quentin-z80/qsbc-zero/qsbc-zero.kicad_pcb

## KiCad design qsbc-zero.kicad_pcb (2022-08-09)

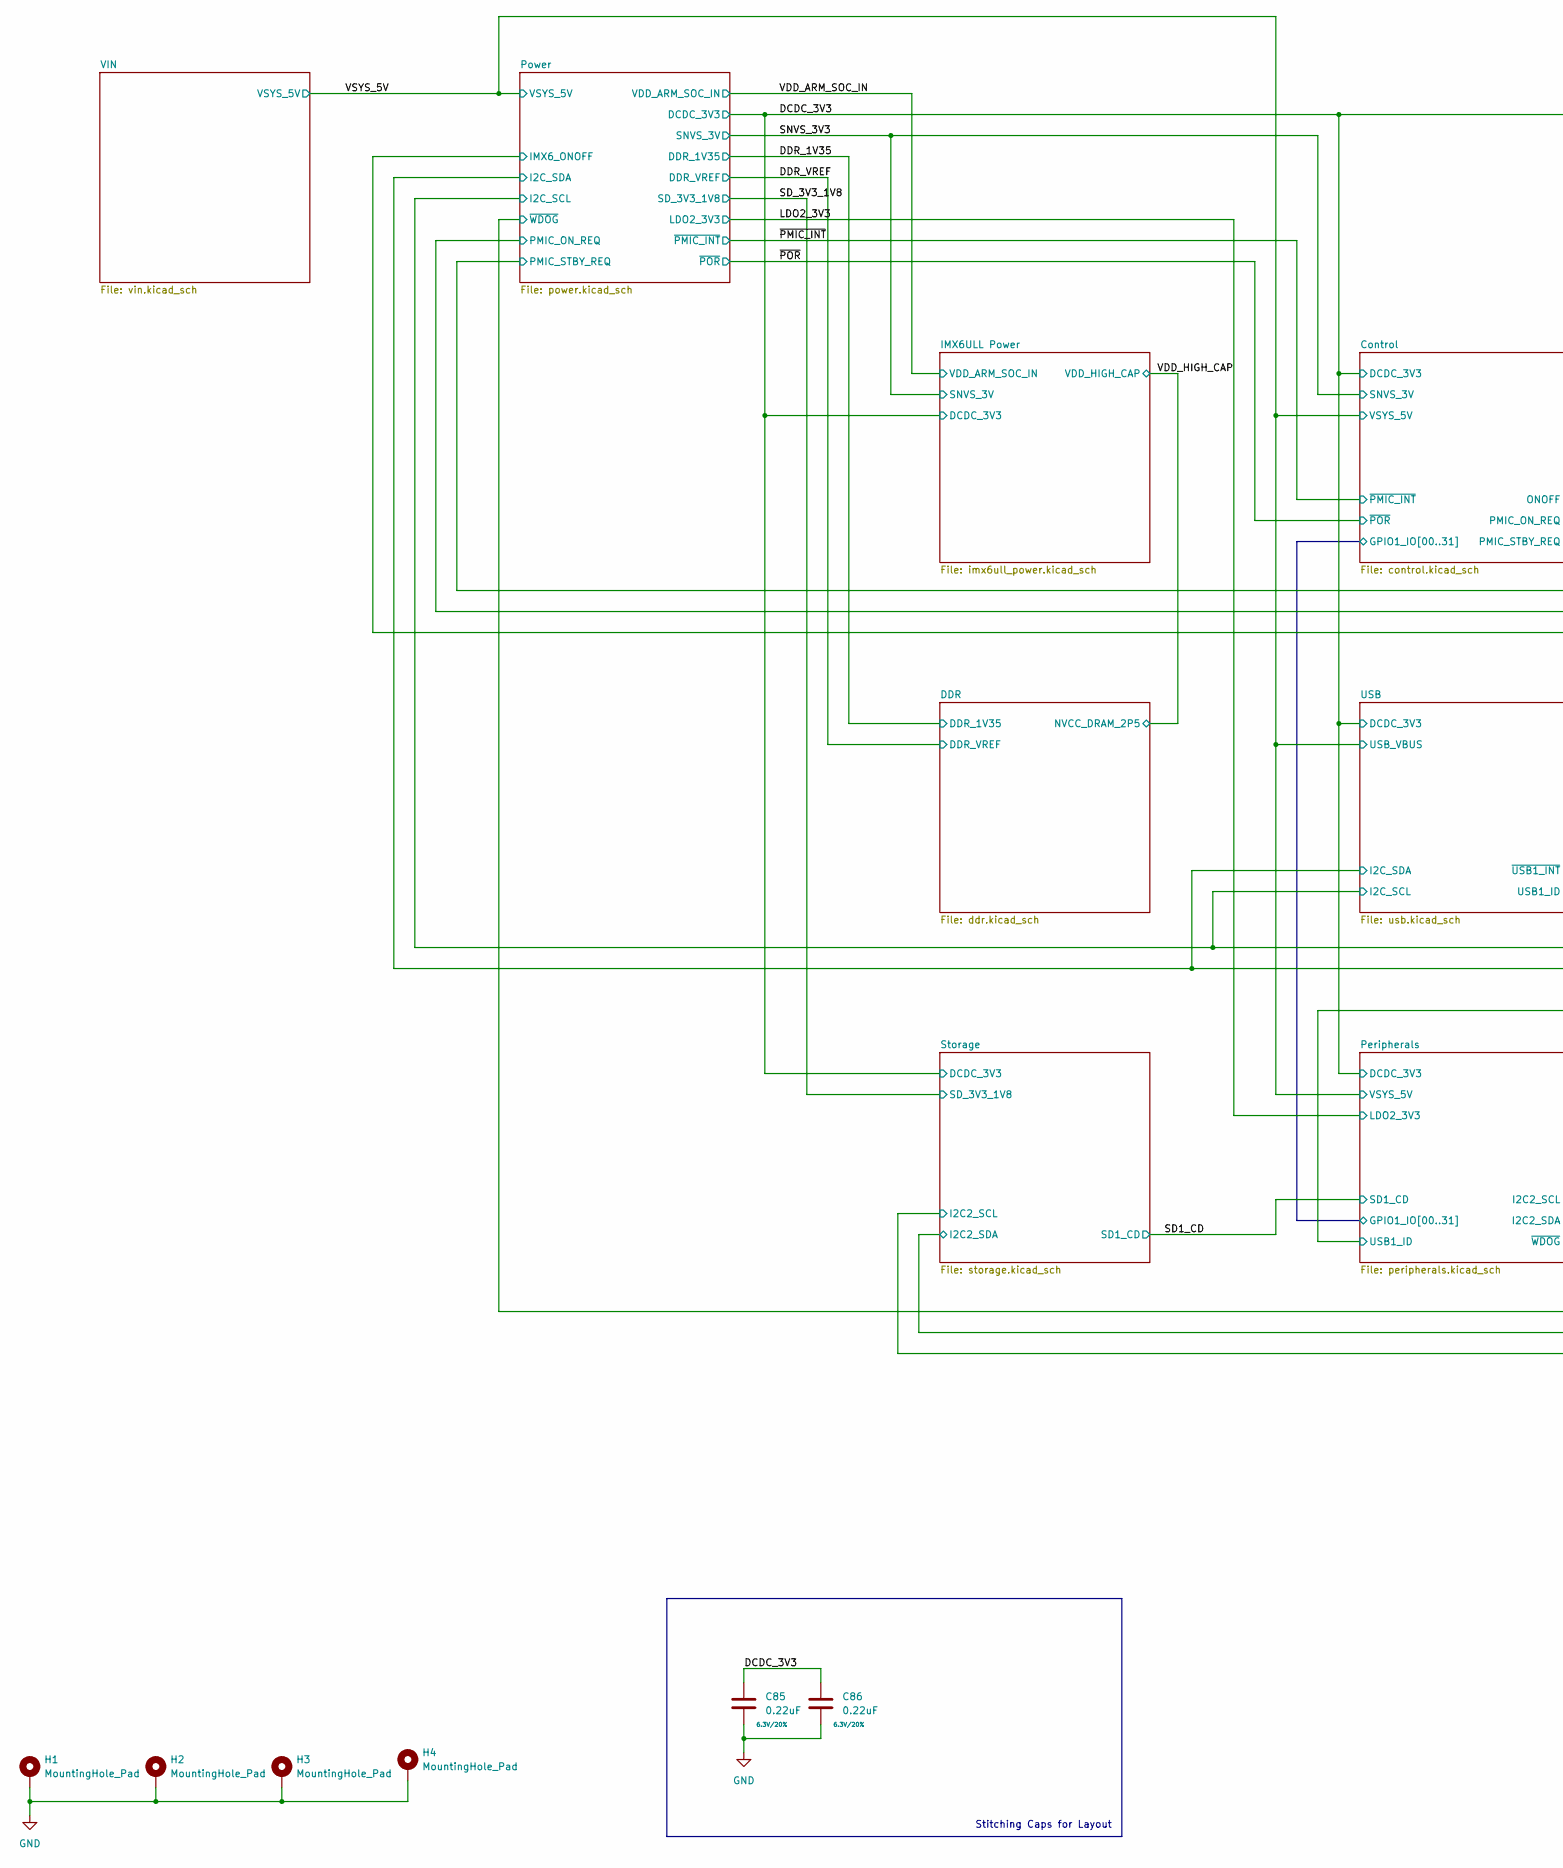
[picture p3: schematic qsbc-zero.kicad_sch, part in row 1, column 1]

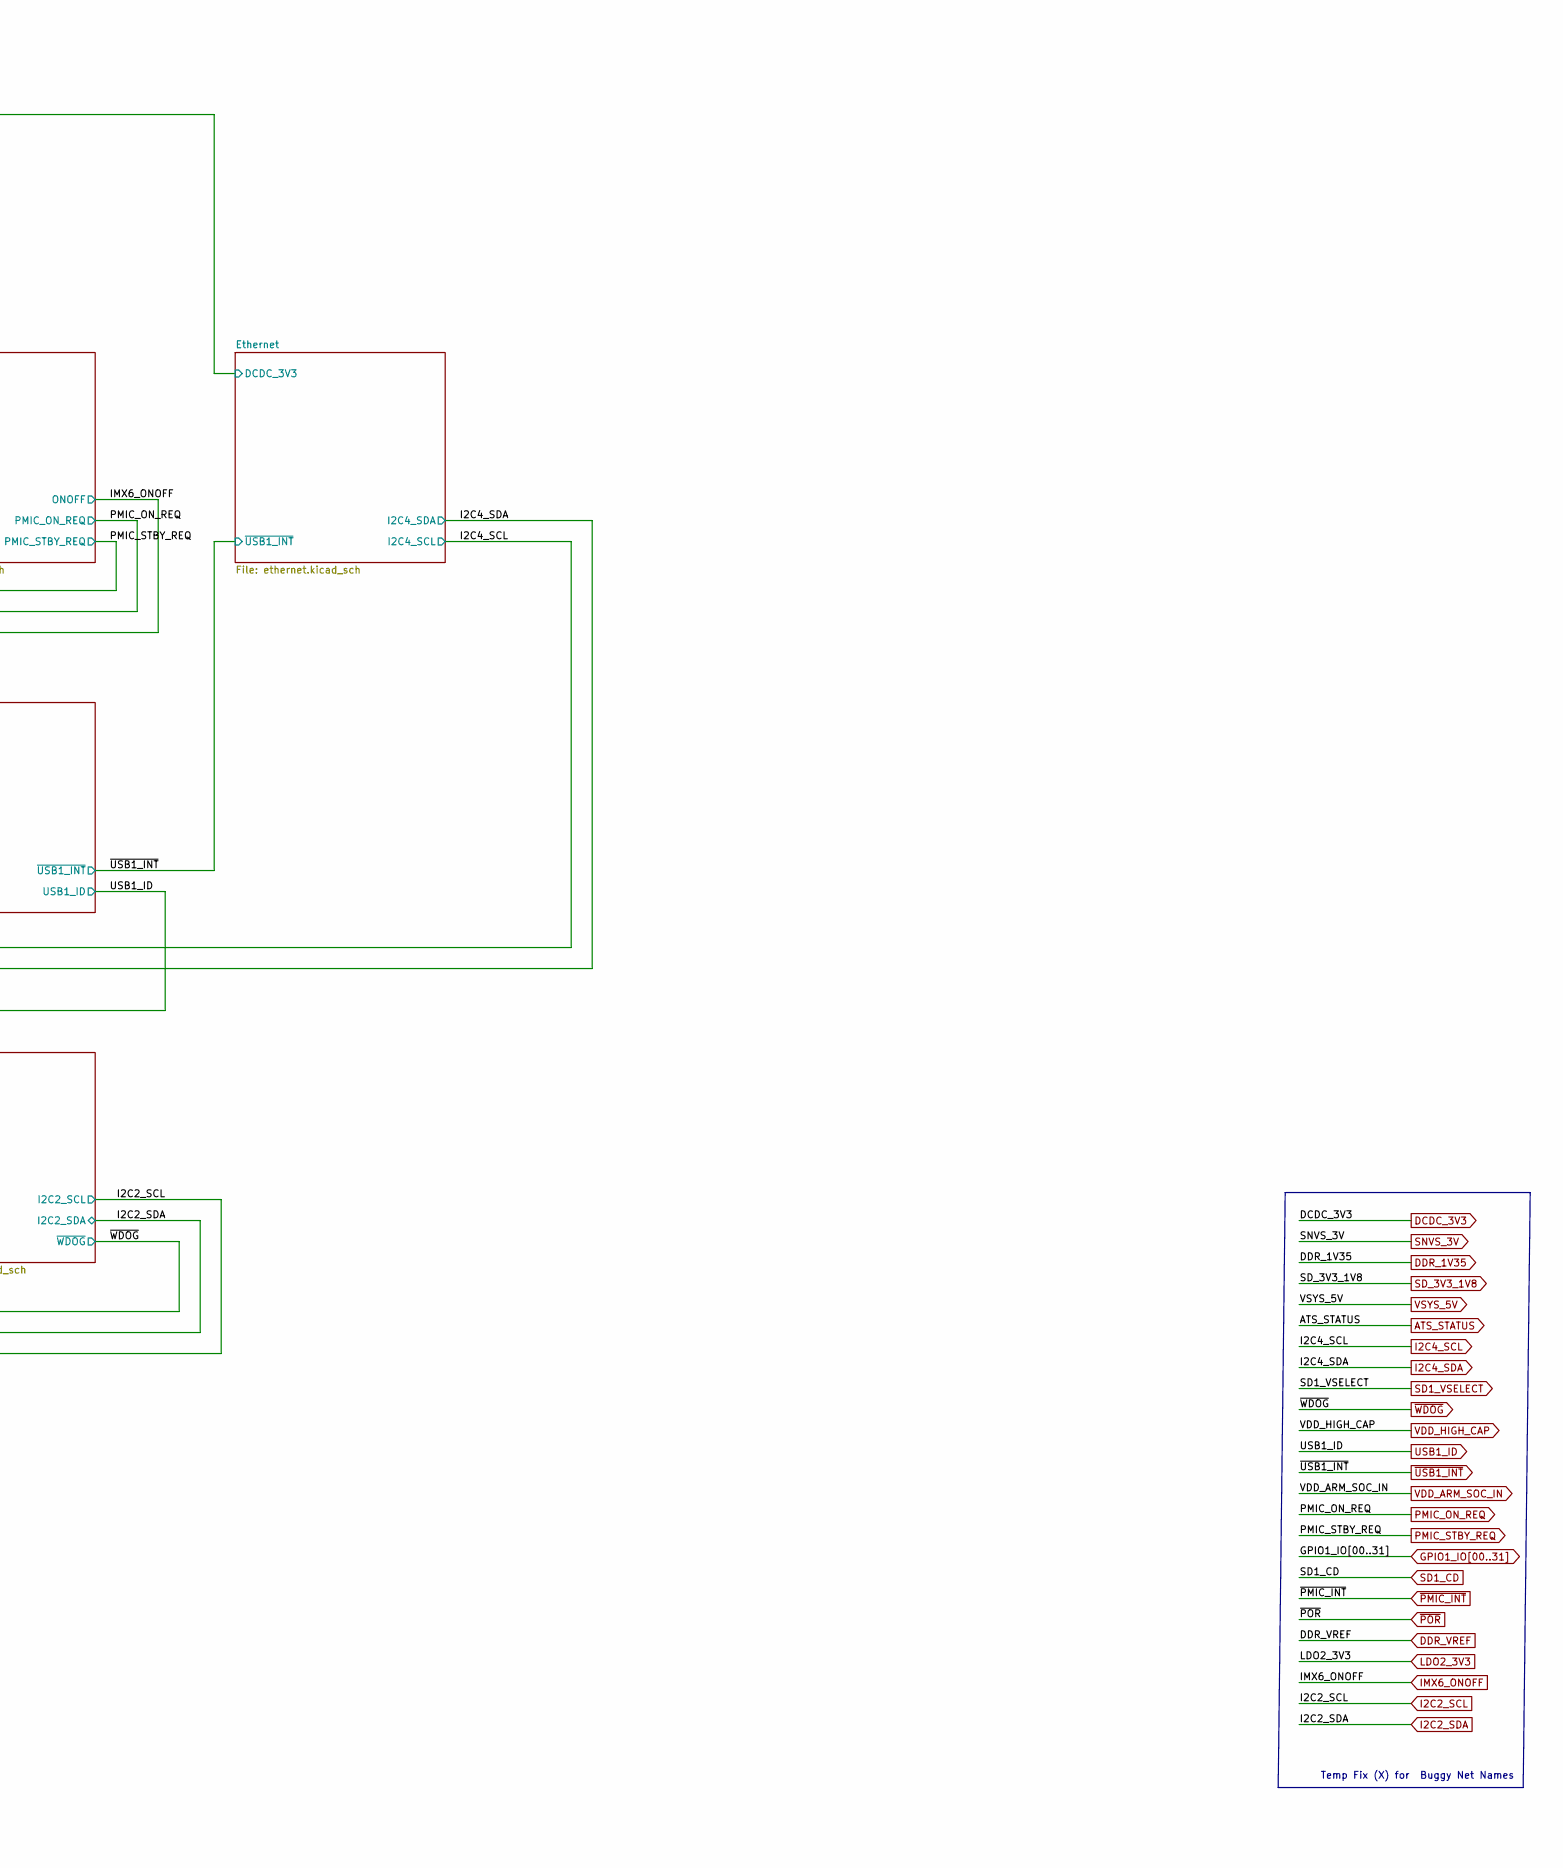
[picture p4: schematic qsbc-zero.kicad_sch, part in row 1, column 2]

Parts:
C85, C86: 0.22uF; C_0201_0603Metric; Rating 6.3V/20%; MPN GRM033C80J224KE90D; DigiKey_PN 490-10392-1-ND
H1, H2, H3, H4: MountingHole_Pad; MountingHole_3.2mm_M3_Pad_Via

Connections:
DCDC_3V3: C85.1, C86.1; also elsewhere on the board
GND: C85.2, C86.2, H1.1, H2.1, H3.1, H4.1; also elsewhere on the board

Notes on the sheet:
Stitching Caps for Layout
Temp Fix (X) for Buggy Net Names

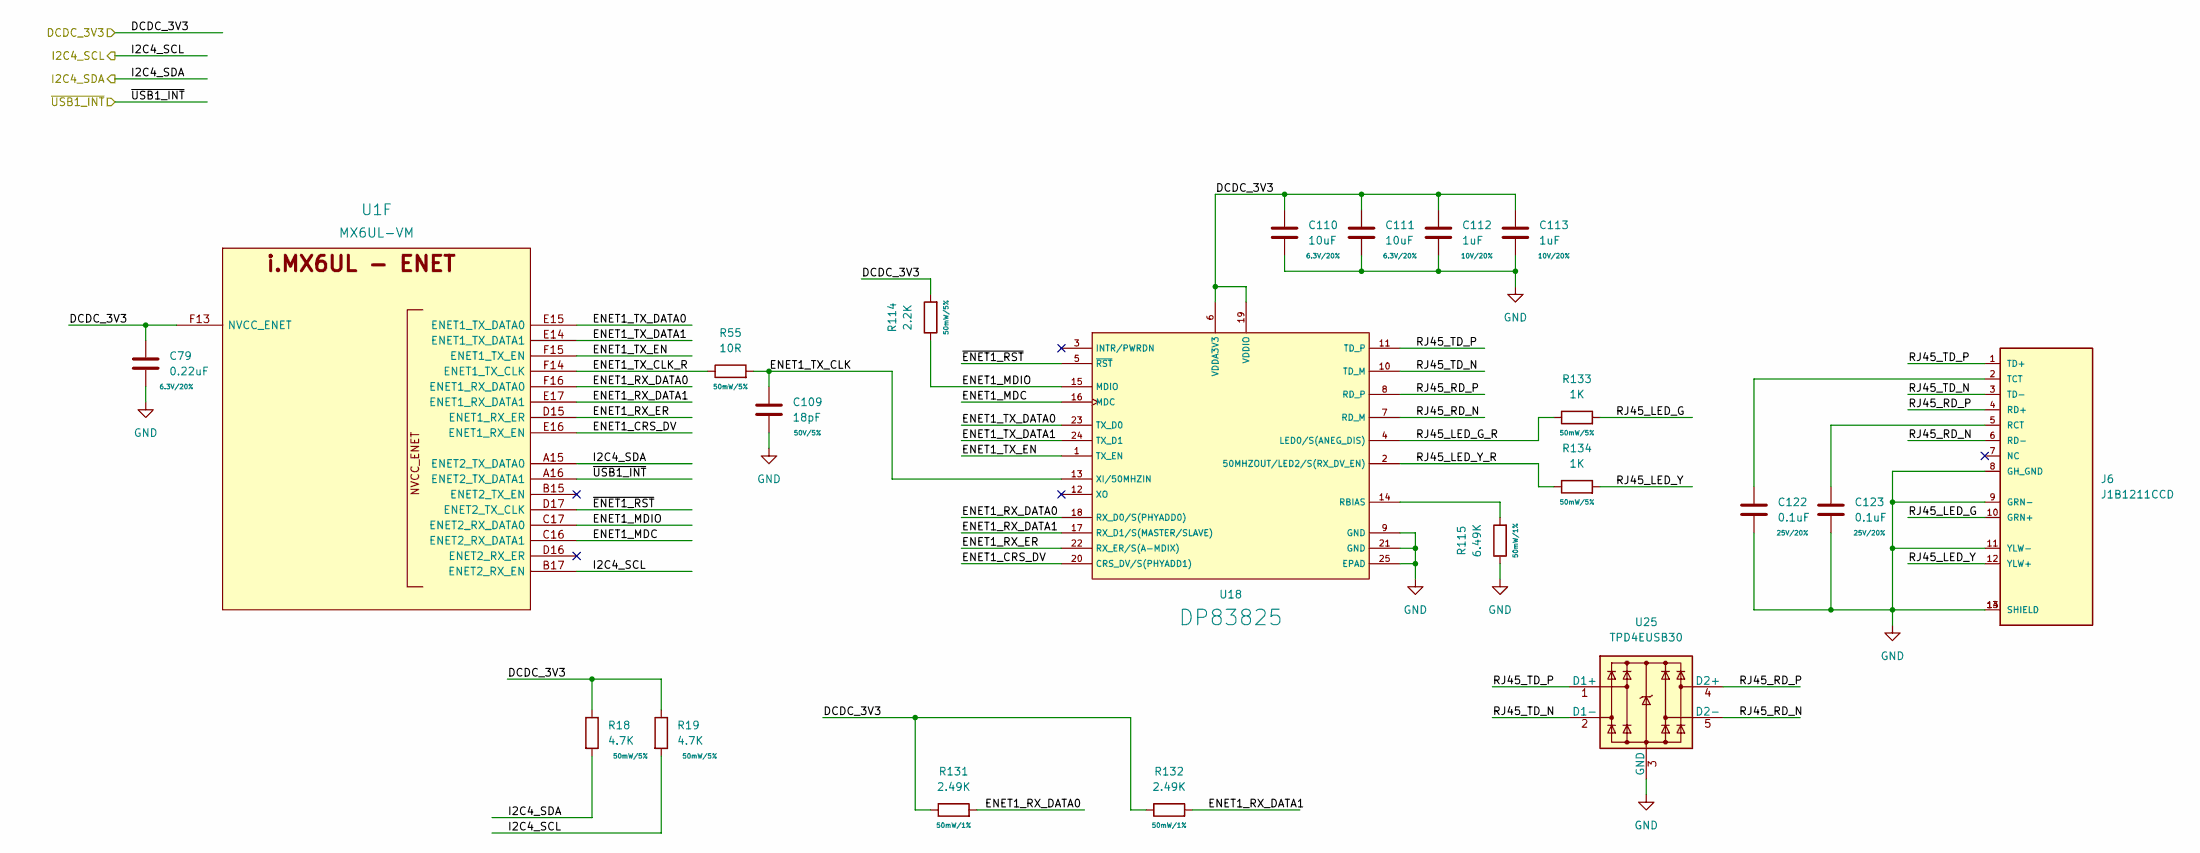
[picture p5: schematic ethernet.kicad_sch]

Parts:
C79: 0.22uF; C_0201_0603Metric; Rating 6.3V/20%; MPN GRM033C80J224KE90D; DigiKey_PN 490-10392-1-ND
C109: 18pF; C_0402_1005Metric; Rating 50V/5%; MPN CC0402JRNPO9BN180; DigiKey_PN 311-1415-1-ND
C110, C111: 10uF; C_0402_1005Metric; Rating 6.3V/20%; MPN GRM155R60J106ME05D; DigiKey_PN 490-GRM155R60J106ME05DCT-ND
C112, C113: 1uF; C_0402_1005Metric; Rating 10V/20%; MPN GCM155C71A105KE38D; DigiKey_PN 490-13409-1-ND
C122, C123: 0.1uF; C_0402_1005Metric; Rating 25V/20%; MPN GRM155R71E104KE14J; DigiKey_PN 490-14603-1-ND
J6: J1B1211CCD; MPN J1B1211CCD; DigiKey_PN 1278-1052-ND
R18, R19: 4.7K; R_0402_1005Metric; Rating 50mW/5%; MPN RC0402JR-074K7L; DigiKey_PN 311-4.7KJRCT-ND
R55: 10R; R_0402_1005Metric; Rating 50mW/5%; MPN RC0402JR-0710RL; DigiKey_PN 311-10JRCT-ND
R114: 2.2K; R_0402_1005Metric; Rating 50mW/5%; MPN RC0402JR-072K2L; DigiKey_PN 311-2.2KJRCT-ND
R115: 6.49K; R_0402_1005Metric; Rating 50mW/1%; MPN RC0402FR-076K49L; DigiKey_PN 311-6.49KLRCT-ND
R131, R132: 2.49K; R_0402_1005Metric; Rating 50mW/1%; MPN RC0402FR-072K49L; DigiKey_PN 311-2.49KLRCT-ND
R133, R134: 1K; R_0402_1005Metric; Rating 50mW/5%; MPN RC0402JR-071KL; DigiKey_PN 311-1.0KJRCT-ND
U1: MX6UL-VM; SOT1534-2; MPN MCIMX6Y2DVM09AB; DigiKey_PN 568-14995-ND
U18: DP83825; XCVR_DP83825IRMQR; MPN DP83825IRMQR; DigiKey_PN 296-DP83825IRMQRCT-ND
U25: TPD4EUSB30; USON-10_2.5x1.0mm_P0.5mm; MPN TPD4EUSB30DQAR; DigiKey_PN 296-28063-1-ND

Connections:
/Ethernet/ENET1_CRS_DV: U1.E16 (ENET1_RX_EN), U18.20 (CRS_DV/S(PHYADD1))
/Ethernet/ENET1_MDC: U1.C16 (ENET2_RX_DATA1), U18.16 (MDC)
/Ethernet/ENET1_MDIO: R114.1, U1.C17 (ENET2_RX_DATA0), U18.15 (MDIO)
/Ethernet/ENET1_RX_DATA0: R131.2, U1.F16 (ENET1_RX_DATA0), U18.18 (RX_D0/S(PHYADD0))
/Ethernet/ENET1_RX_DATA1: R132.2, U1.E17 (ENET1_RX_DATA1), U18.17 (RX_D1/S(MASTER/SLAVE))
/Ethernet/ENET1_RX_ER: U1.D15 (ENET1_RX_ER), U18.22 (RX_ER/S(A-MDIX))
/Ethernet/ENET1_TX_CLK: C109.1, R55.2, U18.13 (XI/50MHZIN)
/Ethernet/ENET1_TX_CLK_R: R55.1, U1.F14 (ENET1_TX_CLK)
/Ethernet/ENET1_TX_DATA0: U1.E15 (ENET1_TX_DATA0), U18.23 (TX_D0)
/Ethernet/ENET1_TX_DATA1: U1.E14 (ENET1_TX_DATA1), U18.24 (TX_D1)
/Ethernet/ENET1_TX_EN: U1.F15 (ENET1_TX_EN), U18.1 (TX_EN)
/Ethernet/RJ45_LED_G: J6.10 (GRN+), R133.2
/Ethernet/RJ45_LED_G_R: R133.1, U18.4 (LED0/S(ANEG_DIS))
/Ethernet/RJ45_LED_Y: J6.12 (YLW+), R134.2
/Ethernet/RJ45_LED_Y_R: R134.1, U18.2 (50MHZOUT/LED2/S(RX_DV_EN))
/Ethernet/RJ45_RD_N: J6.6 (RD-), U18.7 (RD_M), U25.5 (D2-), U25.6
/Ethernet/RJ45_RD_P: J6.4 (RD+), U18.8 (RD_P), U25.4 (D2+), U25.7
/Ethernet/RJ45_TD_N: J6.3 (TD-), U18.10 (TD_M), U25.2 (D1-), U25.9
/Ethernet/RJ45_TD_P: J6.1 (TD+), U18.11 (TD_P), U25.1 (D1+), U25.10
/Ethernet/~ENET1_RST: U1.D17 (ENET2_TX_CLK), U18.5 (~RST)
DCDC_3V3: C79.1, C110.1, C111.1, C112.1, C113.1, R18.1, R19.1, R114.2, R131.1, R132.1, U1.F13 (NVCC_ENET), U18.6 (VDDA3V3), U18.19 (VDDIO); also elsewhere on the board
GND: C79.2, C109.2, C110.2, C111.2, C112.2, C113.2, C122.2, C123.2, J6.8 (GH_GND), J6.9 (GRN-), J6.11 (YLW-), J6.13 (SHIELD), J6.14 (SHIELD), R115.1, U18.9 (GND), U18.21 (GND), U18.25 (EPAD), U18.26 (EPAD), U18.27 (EPAD), U18.28 (EPAD), U18.29 (EPAD), U18.30 (EPAD), U25.3 (GND), U25.8 (GND); also elsewhere on the board
I2C4_SCL: R19.2, U1.B17 (ENET2_RX_EN); also elsewhere on the board
I2C4_SDA: R18.2, U1.A15 (ENET2_TX_DATA0); also elsewhere on the board
unnamed: C122.1, J6.2 (TCT)
unnamed: C123.1, J6.5 (RCT)
unnamed: R115.2, U18.14 (RBIAS)
~USB1_INT: U1.A16 (ENET2_TX_DATA1); also elsewhere on the board

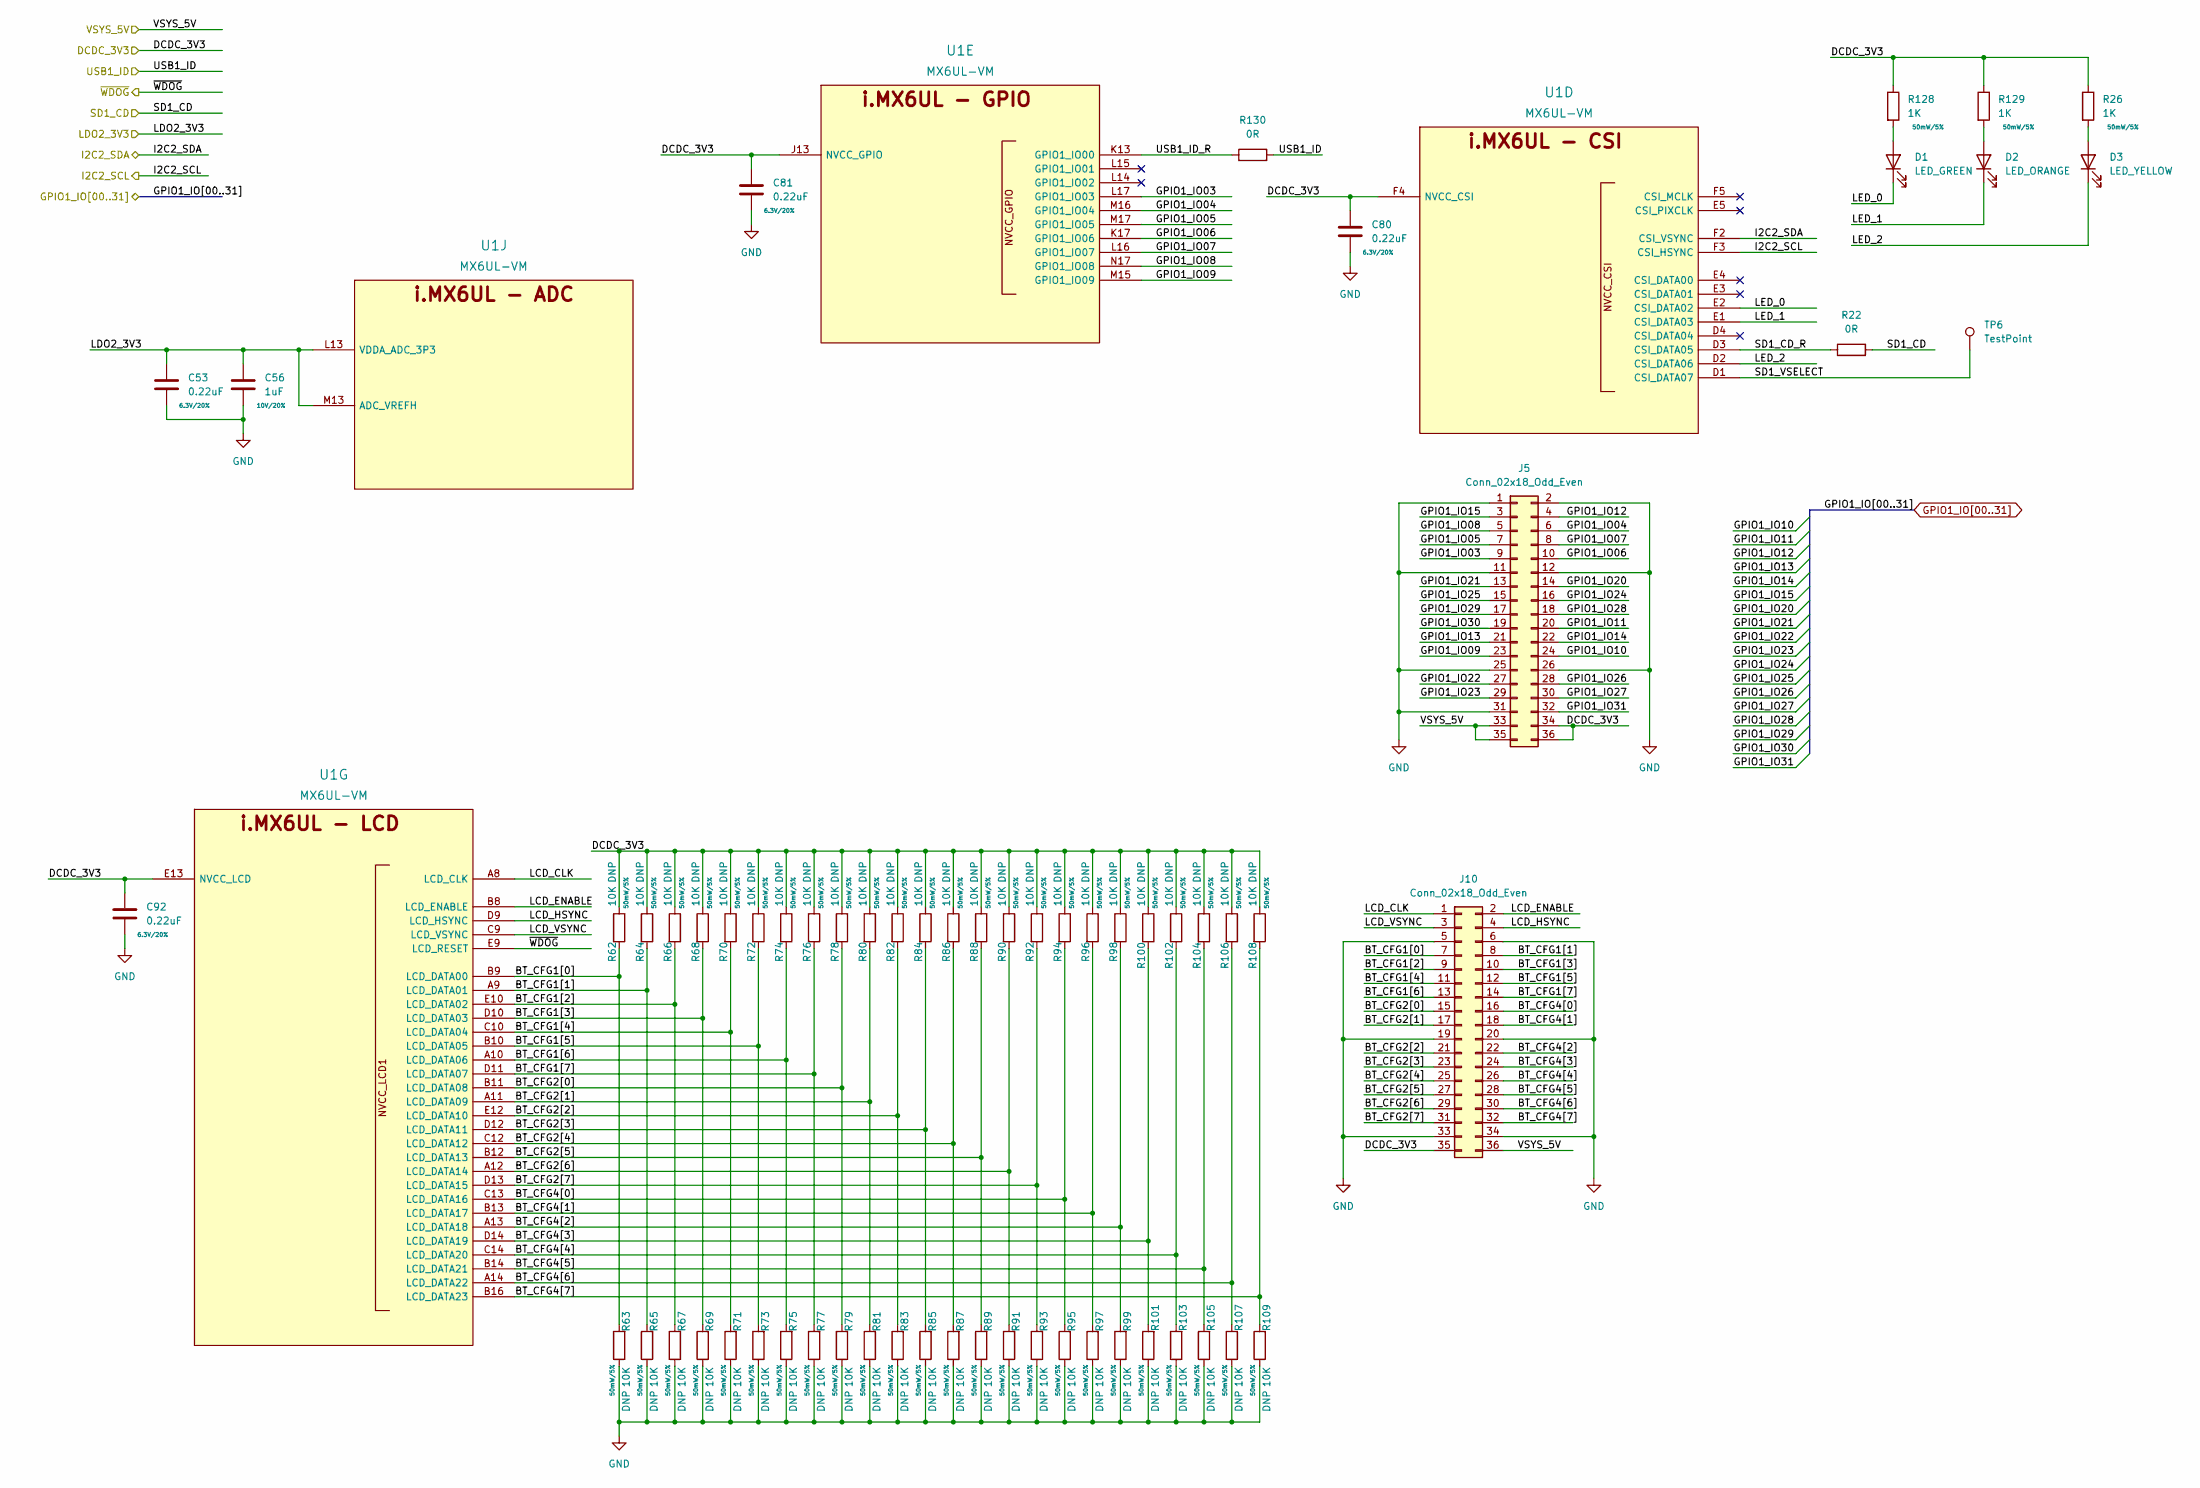
[picture p6: schematic peripherals.kicad_sch]

Parts:
C53, C80, C81, C92: 0.22uF; C_0201_0603Metric; Rating 6.3V/20%; MPN GRM033C80J224KE90D; DigiKey_PN 490-10392-1-ND
C56: 1uF; C_0402_1005Metric; Rating 10V/20%; MPN GCM155C71A105KE38D; DigiKey_PN 490-13409-1-ND
D1: LED_GREEN; LED_0603_1608Metric; MPN SML-D12M8WT86; DigiKey_PN 511-1578-1-ND
D2: LED_ORANGE; LED_0603_1608Metric; MPN SML-E12D8WT86; DigiKey_PN 511-1583-1-ND
D3: LED_YELLOW; LED_0603_1608Metric; MPN SML-E12Y8WT86; DigiKey_PN 511-1588-1-ND
J5, J10: Conn_02x18_Odd_Even; PinHeader_2x18_P2.54mm_Vertical; MPN PRPC018DAAN-RC; DigiKey_PN S2011EC-18-ND
R22, R130: 0R; R_0402_1005Metric; MPN RC0402FR-070RL; DigiKey_PN 311-0.0LRCT-ND
R26, R128, R129: 1K; R_0402_1005Metric; Rating 50mW/5%; MPN RC0402JR-071KL; DigiKey_PN 311-1.0KJRCT-ND
R62, R63, R64, R65, R66, R67, R68, R69, R70, R71, R72, R73, R74, R75, R76, R77, R78, R79, R80, R81, R82, R83, R84, R85, R86, R87, R88, R89, R90, R91, R92, R93, R94, R95, R96, R97, R98, R99, R100, R101, R102, R103, R104, R105, R106, R107, R108, R109: 10K; R_0402_1005Metric; Rating 50mW/5%; MPN RC0402JR-0710KL; DigiKey_PN 311-10KJRCT-ND
TP6: TestPoint; TestPoint_Pad_D1.0mm
U1: MX6UL-VM; SOT1534-2; MPN MCIMX6Y2DVM09AB; DigiKey_PN 568-14995-ND

Connections:
/Peripherals/BT_CFG1[0]: J10.7, R62.2, R63.2, U1.B9 (LCD_DATA00)
/Peripherals/BT_CFG1[1]: J10.8, R64.2, R65.2, U1.A9 (LCD_DATA01)
/Peripherals/BT_CFG1[2]: J10.9, R66.2, R67.2, U1.E10 (LCD_DATA02)
/Peripherals/BT_CFG1[3]: J10.10, R68.2, R69.2, U1.D10 (LCD_DATA03)
/Peripherals/BT_CFG1[4]: J10.11, R70.2, R71.2, U1.C10 (LCD_DATA04)
/Peripherals/BT_CFG1[5]: J10.12, R72.2, R73.2, U1.B10 (LCD_DATA05)
/Peripherals/BT_CFG1[6]: J10.13, R74.2, R75.2, U1.A10 (LCD_DATA06)
/Peripherals/BT_CFG1[7]: J10.14, R76.2, R77.2, U1.D11 (LCD_DATA07)
/Peripherals/BT_CFG2[0]: J10.15, R78.2, R79.2, U1.B11 (LCD_DATA08)
/Peripherals/BT_CFG2[1]: J10.17, R80.2, R81.2, U1.A11 (LCD_DATA09)
/Peripherals/BT_CFG2[2]: J10.21, R82.2, R83.2, U1.E12 (LCD_DATA10)
/Peripherals/BT_CFG2[3]: J10.23, R84.2, R85.2, U1.D12 (LCD_DATA11)
/Peripherals/BT_CFG2[4]: J10.25, R86.2, R87.2, U1.C12 (LCD_DATA12)
/Peripherals/BT_CFG2[5]: J10.27, R88.2, R89.2, U1.B12 (LCD_DATA13)
/Peripherals/BT_CFG2[6]: J10.29, R90.2, R91.2, U1.A12 (LCD_DATA14)
/Peripherals/BT_CFG2[7]: J10.31, R92.2, R93.2, U1.D13 (LCD_DATA15)
/Peripherals/BT_CFG4[0]: J10.16, R94.2, R95.2, U1.C13 (LCD_DATA16)
/Peripherals/BT_CFG4[1]: J10.18, R96.2, R97.2, U1.B13 (LCD_DATA17)
/Peripherals/BT_CFG4[2]: J10.22, R98.2, R99.2, U1.A13 (LCD_DATA18)
/Peripherals/BT_CFG4[3]: J10.24, R100.2, R101.2, U1.D14 (LCD_DATA19)
/Peripherals/BT_CFG4[4]: J10.26, R102.2, R103.2, U1.C14 (LCD_DATA20)
/Peripherals/BT_CFG4[5]: J10.28, R104.2, R105.2, U1.B14 (LCD_DATA21)
/Peripherals/BT_CFG4[6]: J10.30, R106.2, R107.2, U1.A14 (LCD_DATA22)
/Peripherals/BT_CFG4[7]: J10.32, R108.2, R109.2, U1.B16 (LCD_DATA23)
/Peripherals/GPIO1_IO03: J5.9, U1.L17 (GPIO1_IO03)
/Peripherals/GPIO1_IO04: J5.6, U1.M16 (GPIO1_IO04)
/Peripherals/GPIO1_IO05: J5.7, U1.M17 (GPIO1_IO05)
/Peripherals/GPIO1_IO06: J5.10, U1.K17 (GPIO1_IO06)
/Peripherals/GPIO1_IO07: J5.8, U1.L16 (GPIO1_IO07)
/Peripherals/GPIO1_IO08: J5.5, U1.N17 (GPIO1_IO08)
/Peripherals/GPIO1_IO09: J5.23, U1.M15 (GPIO1_IO09)
/Peripherals/LCD_CLK: J10.1, U1.A8 (LCD_CLK)
/Peripherals/LCD_ENABLE: J10.2, U1.B8 (LCD_ENABLE)
/Peripherals/LCD_HSYNC: J10.4, U1.D9 (LCD_HSYNC)
/Peripherals/LCD_VSYNC: J10.3, U1.C9 (LCD_VSYNC)
/Peripherals/LED_0: D1.1 (K), U1.E2 (CSI_DATA02)
/Peripherals/LED_1: D2.1 (K), U1.E1 (CSI_DATA03)
/Peripherals/LED_2: D3.1 (K), U1.D2 (CSI_DATA06)
/Peripherals/SD1_CD_R: R22.1, U1.D3 (CSI_DATA05)
/Peripherals/SD1_VSELECT: TP6.1, U1.D1 (CSI_DATA07)
/Peripherals/USB1_ID_R: R130.1, U1.K13 (GPIO1_IO00)
DCDC_3V3: C80.1, C81.1, C92.1, J5.34, J5.36, J10.35, R26.1, R62.1, R64.1, R66.1, R68.1, R70.1, R72.1, R74.1, R76.1, R78.1, R80.1, R82.1, R84.1, R86.1, R88.1, R90.1, R92.1, R94.1, R96.1, R98.1, R100.1, R102.1, R104.1, R106.1, R108.1, R128.1, R129.1, U1.E13 (NVCC_LCD), U1.F4 (NVCC_CSI), U1.J13 (NVCC_GPIO); also elsewhere on the board
GND: C53.2, C56.2, C80.2, C81.2, C92.2, J5.1, J5.2, J5.11, J5.12, J5.25, J5.26, J5.31, J10.5, J10.6, J10.19, J10.20, J10.33, J10.34, R63.1, R65.1, R67.1, R69.1, R71.1, R73.1, R75.1, R77.1, R79.1, R81.1, R83.1, R85.1, R87.1, R89.1, R91.1, R93.1, R95.1, R97.1, R99.1, R101.1, R103.1, R105.1, R107.1, R109.1; also elsewhere on the board
GPIO1_IO10: J5.24; also elsewhere on the board
GPIO1_IO11: J5.20; also elsewhere on the board
GPIO1_IO12: J5.4; also elsewhere on the board
GPIO1_IO13: J5.21; also elsewhere on the board
GPIO1_IO14: J5.22; also elsewhere on the board
GPIO1_IO15: J5.3; also elsewhere on the board
GPIO1_IO20: J5.14; also elsewhere on the board
GPIO1_IO21: J5.13; also elsewhere on the board
GPIO1_IO22: J5.27; also elsewhere on the board
GPIO1_IO23: J5.29; also elsewhere on the board
GPIO1_IO24: J5.16; also elsewhere on the board
GPIO1_IO25: J5.15; also elsewhere on the board
GPIO1_IO26: J5.28; also elsewhere on the board
GPIO1_IO27: J5.30; also elsewhere on the board
GPIO1_IO28: J5.18; also elsewhere on the board
GPIO1_IO29: J5.17; also elsewhere on the board
GPIO1_IO30: J5.19; also elsewhere on the board
GPIO1_IO31: J5.32; also elsewhere on the board
I2C2_SCL: U1.F3 (CSI_HSYNC); also elsewhere on the board
I2C2_SDA: U1.F2 (CSI_VSYNC); also elsewhere on the board
LDO2_3V3: C53.1, C56.1, U1.L13 (VDDA_ADC_3P3), U1.M13 (ADC_VREFH); also elsewhere on the board
unnamed: D1.2 (A), R128.2
unnamed: D2.2 (A), R129.2
unnamed: D3.2 (A), R26.2
SD1_CD: R22.2; also elsewhere on the board
USB1_ID: R130.2; also elsewhere on the board
VSYS_5V: J5.33, J5.35, J10.36; also elsewhere on the board
~WDOG: U1.E9 (LCD_RESET); also elsewhere on the board

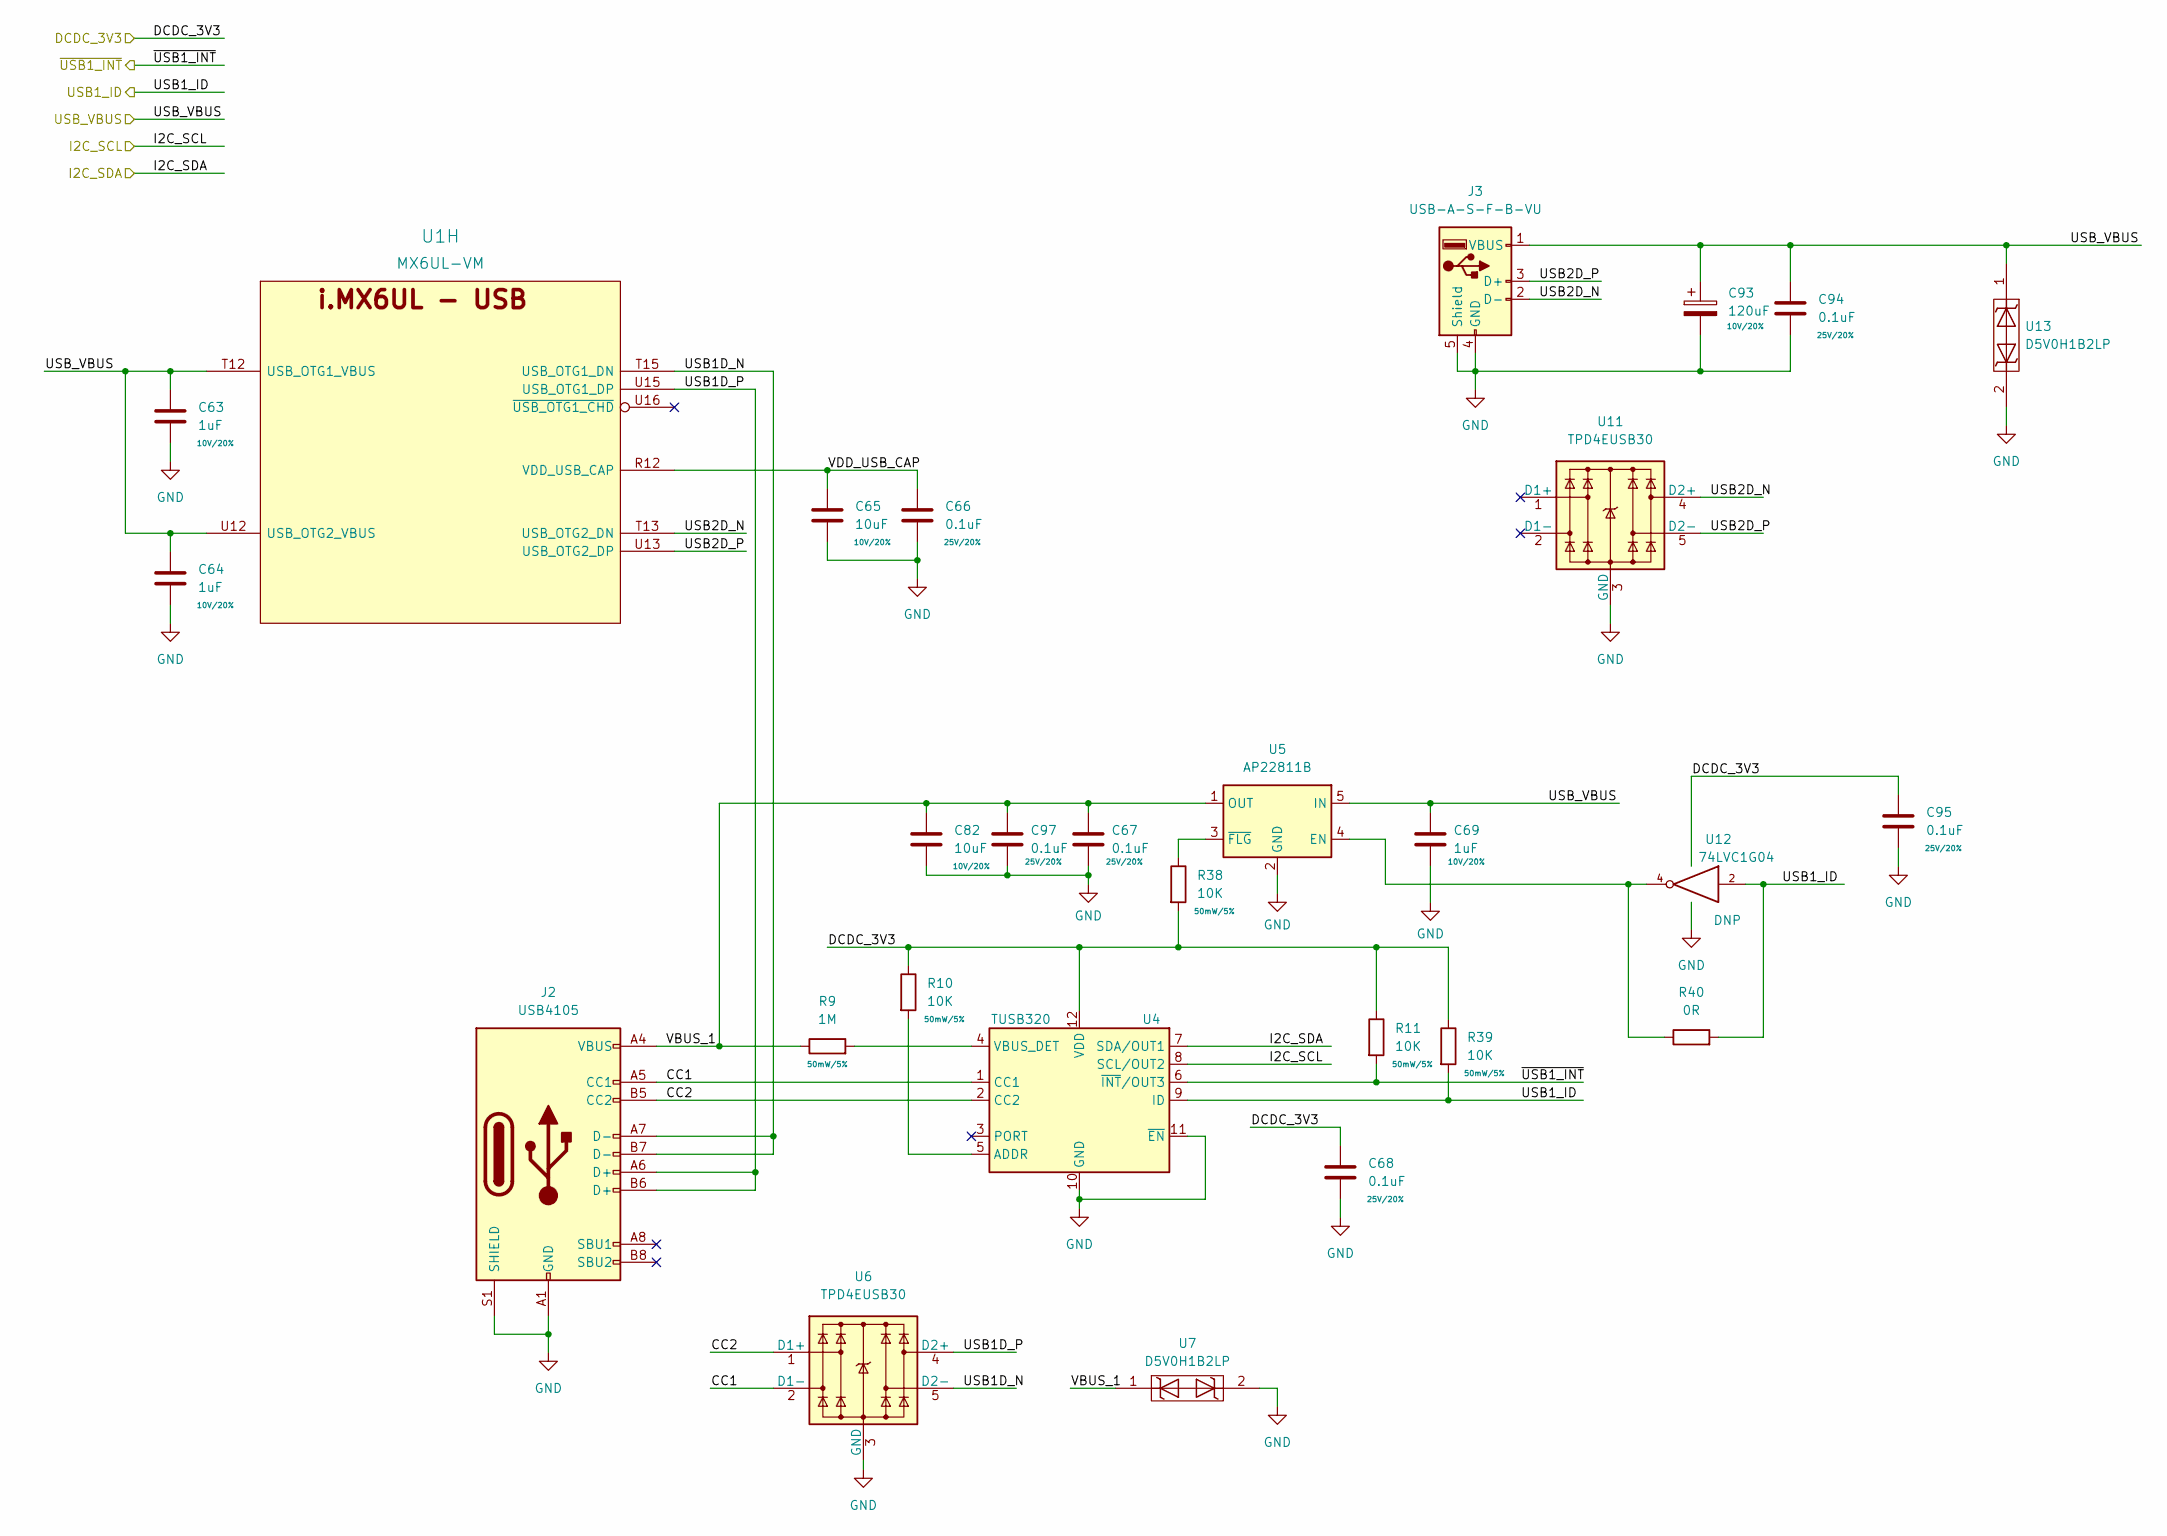
[picture p7: schematic usb.kicad_sch]

Parts:
C63, C64, C69: 1uF; C_0402_1005Metric; Rating 10V/20%; MPN GCM155C71A105KE38D; DigiKey_PN 490-13409-1-ND
C65, C82: 10uF; C_0402_1005Metric; Rating 10V/20%; MPN CL05A106MP5NUNC; DigiKey_PN 1276-1450-1-ND
C66, C67, C68, C94, C95, C97: 0.1uF; C_0402_1005Metric; Rating 25V/20%; MPN GRM155R71E104KE14J; DigiKey_PN 490-14603-1-ND
C93: 120uF; CP_Elec_6.3x4.9; Rating 10V/20%; MPN 875105244013; DigiKey_PN 732-6413-1-ND
J2: USB4105; USB_C_Receptacle_HRO_TYPE-C-31-M-12; MPN USB4105-GF-A; DigiKey_PN 2073-USB4105-GF-ACT-ND
J3: USB-A-S-F-B-VU; SAMTEC_USB-A-S-X-X-VU; MPN USB-A-S-F-B-VU; DigiKey_PN SAM10862-ND
R9: 1M; R_0402_1005Metric; Rating 50mW/5%; MPN RC0402JR-071ML; DigiKey_PN 311-1.0MJRCT-ND
R10, R11, R38, R39: 10K; R_0402_1005Metric; Rating 50mW/5%; MPN RC0402JR-0710KL; DigiKey_PN 311-10KJRCT-ND
R40: 0R; R_0402_1005Metric; MPN RC0402FR-070RL; DigiKey_PN 311-0.0LRCT-ND
U1: MX6UL-VM; SOT1534-2; MPN MCIMX6Y2DVM09AB; DigiKey_PN 568-14995-ND
U4: TUSB320; Texas_X2QFN-12_1.6x1.6mm_P0.4mm; MPN TUSB320LAIRWBR; DigiKey_PN 296-43142-1-ND
U5: AP22811B; SOT-23-5; MPN AP22811BW5-7; DigiKey_PN AP22811BW5-7DICT-ND
U6, U11: TPD4EUSB30; USON-10_2.5x1.0mm_P0.5mm; MPN TPD4EUSB30DQAR; DigiKey_PN 296-28063-1-ND
U7, U13: D5V0H1B2LP; DFN100X60X45-2N; MPN D5V0H1B2LP-7B; DigiKey_PN D5V0H1B2LP-7BDICT-ND
U12: 74LVC1G04; SOT-23-5; MPN SN74LVC1G04DBVR; DigiKey_PN 296-11599-1-ND

Connections:
/USB/CC1: J2.A5 (CC1), U4.1 (CC1), U6.2 (D1-), U6.9
/USB/CC2: J2.B5 (CC2), U4.2 (CC2), U6.1 (D1+), U6.10
/USB/USB1D_N: J2.A7 (D-), J2.B7 (D-), U1.T15 (USB_OTG1_DN), U6.5 (D2-), U6.6
/USB/USB1D_P: J2.A6 (D+), J2.B6 (D+), U1.U15 (USB_OTG1_DP), U6.4 (D2+), U6.7
/USB/USB2D_N: J3.2 (D-), U1.T13 (USB_OTG2_DN), U11.4 (D2+), U11.7
/USB/USB2D_P: J3.3 (D+), U1.U13 (USB_OTG2_DP), U11.5 (D2-), U11.6
/USB/VBUS_1: C67.1, C82.1, C97.1, J2.A4 (VBUS), J2.A9 (VBUS), J2.B4 (VBUS), J2.B9 (VBUS), R9.1, U5.1 (OUT), U7.1
/USB/VDD_USB_CAP: C65.1, C66.1, U1.R12 (VDD_USB_CAP)
DCDC_3V3: C68.1, C95.1, R10.1, R11.1, R38.2, R39.1, U4.12 (VDD), U12.5 (VCC); also elsewhere on the board
GND: C63.2, C64.2, C65.2, C66.2, C67.2, C68.2, C69.2, C82.2, C93.2, C94.2, C95.2, C97.2, J2.A1 (GND), J2.A12 (GND), J2.B1 (GND), J2.B12 (GND), J2.S1 (SHIELD), J3.4 (GND), J3.5 (Shield), U4.10 (GND), U4.11 (~EN), U5.2 (GND), U6.3 (GND), U6.8 (GND), U7.2, U11.3 (GND), U11.8 (GND), U12.3 (GND), U13.2; also elsewhere on the board
I2C4_SCL: U4.8 (SCL/OUT2); also elsewhere on the board
I2C4_SDA: U4.7 (SDA/OUT1); also elsewhere on the board
unnamed: R9.2, U4.4 (VBUS_DET)
unnamed: R10.2, U4.5 (ADDR)
unnamed: R38.1, U5.3 (~FLG)
unnamed: R40.1, U5.4 (EN), U12.4
USB1_ID: R39.2, R40.2, U4.9 (ID), U12.2; also elsewhere on the board
VSYS_5V: C63.1, C64.1, C69.1, C93.1, C94.1, J3.1 (VBUS), U1.T12 (USB_OTG1_VBUS), U1.U12 (USB_OTG2_VBUS), U5.5 (IN), U13.1; also elsewhere on the board
~USB1_INT: R11.2, U4.6 (~INT/OUT3); also elsewhere on the board
