quentin-z80/qsbc-zero/qsbc-zero.kicad_pcb

## KiCad design qsbc-zero.kicad_pcb (continued)

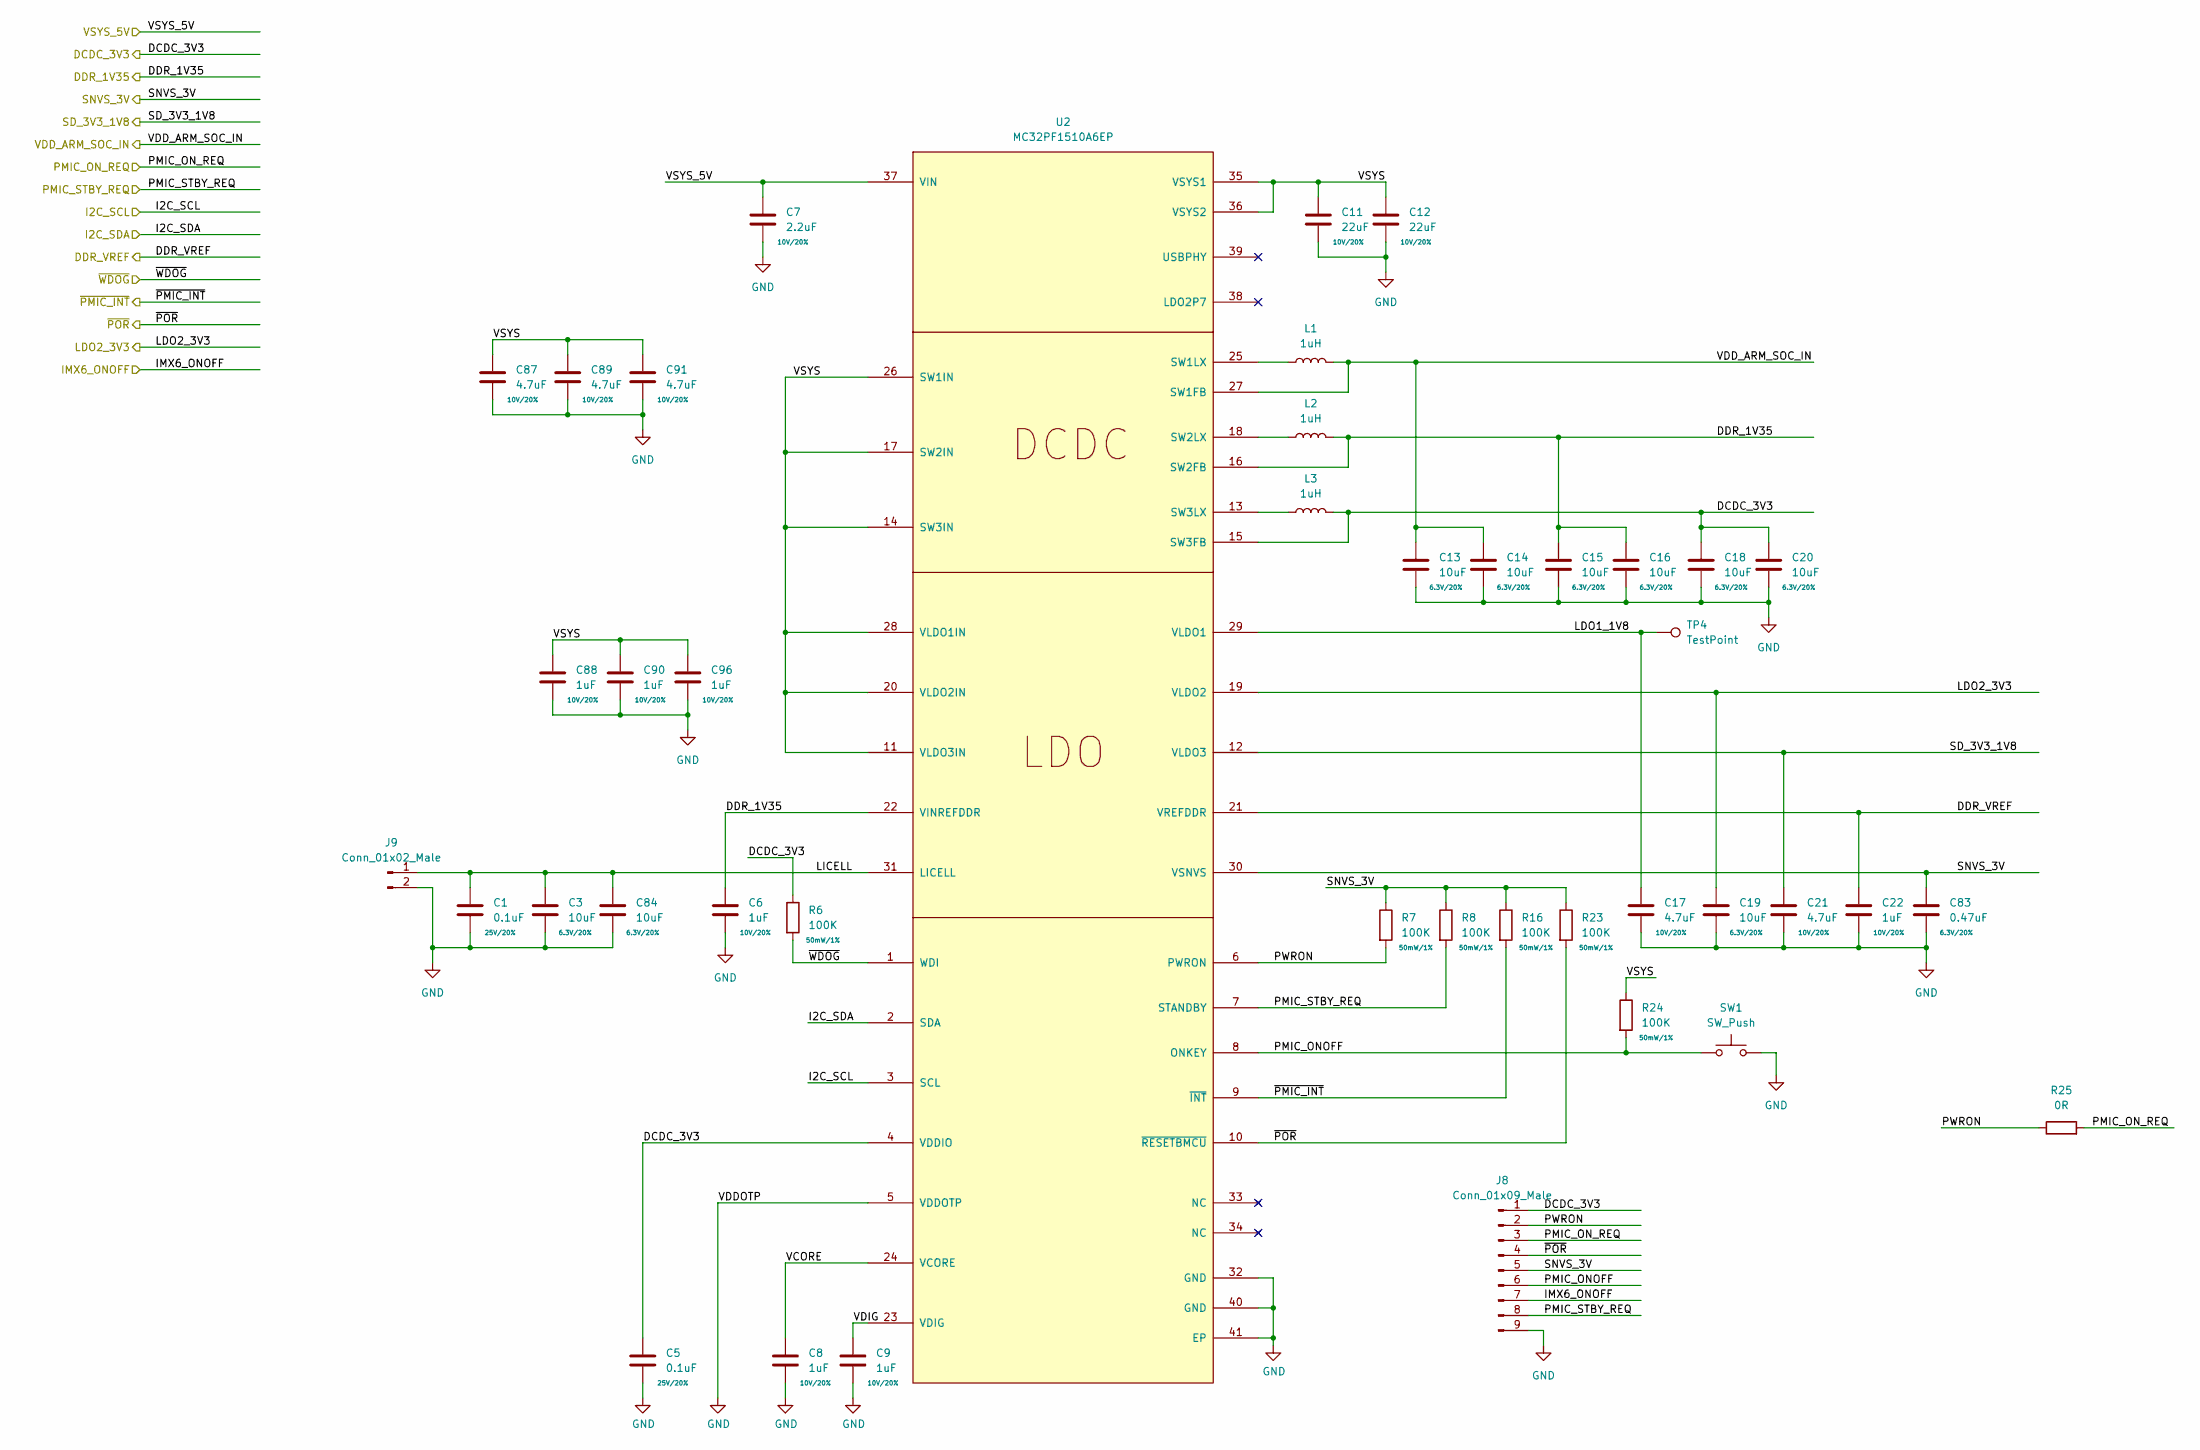
[picture p8: schematic power.kicad_sch]

Parts:
C1, C5: 0.1uF; C_0402_1005Metric; Rating 25V/20%; MPN GRM155R71E104KE14J; DigiKey_PN 490-14603-1-ND
C3, C13, C14, C15, C16, C18, C19, C20, C84: 10uF; C_0402_1005Metric; Rating 6.3V/20%; MPN GRM155R60J106ME05D; DigiKey_PN 490-GRM155R60J106ME05DCT-ND
C6, C8, C9, C22, C88, C90, C96: 1uF; C_0402_1005Metric; Rating 10V/20%; MPN GCM155C71A105KE38D; DigiKey_PN 490-13409-1-ND
C7: 2.2uF; C_0402_1005Metric; Rating 10V/20%; MPN CL05A225MP5NSNC; DigiKey_PN 1276-1467-1-ND
C11, C12: 22uF; C_0603_1608Metric; Rating 10V/20%; MPN CL10A226MP8NUNE; DigiKey_PN 1276-1274-1-ND
C17, C21, C87, C89, C91: 4.7uF; C_0402_1005Metric; Rating 10V/20%; MPN CL05A475MP5NRNC; DigiKey_PN 1276-1482-1-ND
C83: 0.47uF; C_0402_1005Metric; Rating 6.3V/20%; MPN CL05A474KQ5NNNC; DigiKey_PN 1276-1479-1-ND
J8: Conn_01x09_Male; PinHeader_1x09_P1.27mm_Vertical; MPN GRPB091VWVN-RC; DigiKey_PN S9014E-09-ND
J9: Conn_01x02_Male; PinHeader_1x02_P2.54mm_Vertical; MPN PRPC002SAAN-RC; DigiKey_PN S1011EC-02-ND
L1, L2, L3: 1uH; L_0603_1608Metric; MPN DFE18SBN1R0ME0L; DigiKey_PN 490-DFE18SBN1R0ME0LCT-ND
R6, R7, R8, R16, R23, R24: 100K; R_0402_1005Metric; Rating 50mW/1%; MPN CR0402-FX-1003GLF; DigiKey_PN CR0402-FX-1003GLFCT-ND
R25: 0R; R_0402_1005Metric; MPN RC0402FR-070RL; DigiKey_PN 311-0.0LRCT-ND
SW1: SW_Push; SW_Tactile_SPST_Angled_PTS645Vx58-2LFS; MPN PTS645VH58-2 LFS; DigiKey_PN CKN9120-ND
TP4: TestPoint; TestPoint_Pad_D1.0mm
U2: MC32PF1510A6EP; QFN-40-1EP_5x5mm_P0.4mm_EP3.8x3.8mm_ThermalVias; MPN MC32PF1510A6EP; DigiKey_PN MC32PF1510A6EP

Connections:
/Power/LDO1_1V8: C17.1, TP4.1, U2.29 (VLDO1)
/Power/LICELL: C1.1, C3.1, C84.1, J9.1, U2.31 (LICELL)
/Power/PMIC_ONOFF: J8.6, R24.2, SW1.2, U2.8 (ONKEY)
/Power/PWRON: J8.2, R7.2, R25.1, U2.6 (PWRON)
/Power/VCORE: C8.1, U2.24 (VCORE)
/Power/VDIG: C9.1, U2.23 (VDIG)
/Power/VSYS: C11.1, C12.1, C87.1, C88.1, C89.1, C90.1, C91.1, C96.1, R24.1, U2.11 (VLDO3IN), U2.14 (SW3IN), U2.17 (SW2IN), U2.20 (VLDO2IN), U2.26 (SW1IN), U2.28 (VLDO1IN), U2.35 (VSYS1), U2.36 (VSYS2)
/SNVS_3V3: C83.1, J8.5, R7.1, R8.1, R16.1, R23.1, U2.30 (VSNVS); also elsewhere on the board
DCDC_3V3: C5.1, C18.1, C20.1, J8.1, L3.2, R6.1, U2.4 (VDDIO), U2.15 (SW3FB); also elsewhere on the board
DDR_1V35: C6.1, C15.1, C16.1, L2.2, U2.16 (SW2FB), U2.22 (VINREFDDR); also elsewhere on the board
DDR_VREF: C22.1, U2.21 (VREFDDR); also elsewhere on the board
GND: C1.2, C3.2, C5.2, C6.2, C7.2, C8.2, C9.2, C11.2, C12.2, C13.2, C14.2, C15.2, C16.2, C17.2, C18.2, C19.2, C20.2, C21.2, C22.2, C83.2, C84.2, C87.2, C88.2, C89.2, C90.2, C91.2, C96.2, J8.9, J9.2, SW1.1, U2.5 (VDDOTP), U2.32 (GND), U2.40 (GND), U2.41 (EP); also elsewhere on the board
I2C4_SCL: U2.3 (SCL); also elsewhere on the board
I2C4_SDA: U2.2 (SDA); also elsewhere on the board
IMX6_ONOFF: J8.7; also elsewhere on the board
LDO2_3V3: C19.1, U2.19 (VLDO2); also elsewhere on the board
unnamed: L1.1, U2.25 (SW1LX)
unnamed: L2.1, U2.18 (SW2LX)
unnamed: L3.1, U2.13 (SW3LX)
PMIC_ON_REQ: J8.3, R25.2; also elsewhere on the board
PMIC_STBY_REQ: J8.8, R8.2, U2.7 (STANDBY); also elsewhere on the board
SD_3V3_1V8: C21.1, U2.12 (VLDO3); also elsewhere on the board
VDD_ARM_SOC_IN: C13.1, C14.1, L1.2, U2.27 (SW1FB); also elsewhere on the board
VSYS_5V: C7.1, U2.37 (VIN); also elsewhere on the board
~PMIC_INT: R16.2, U2.9 (~INT); also elsewhere on the board
~POR: J8.4, R23.2, U2.10 (~RESETBMCU); also elsewhere on the board
~WDOG: R6.2, U2.1 (WDI); also elsewhere on the board

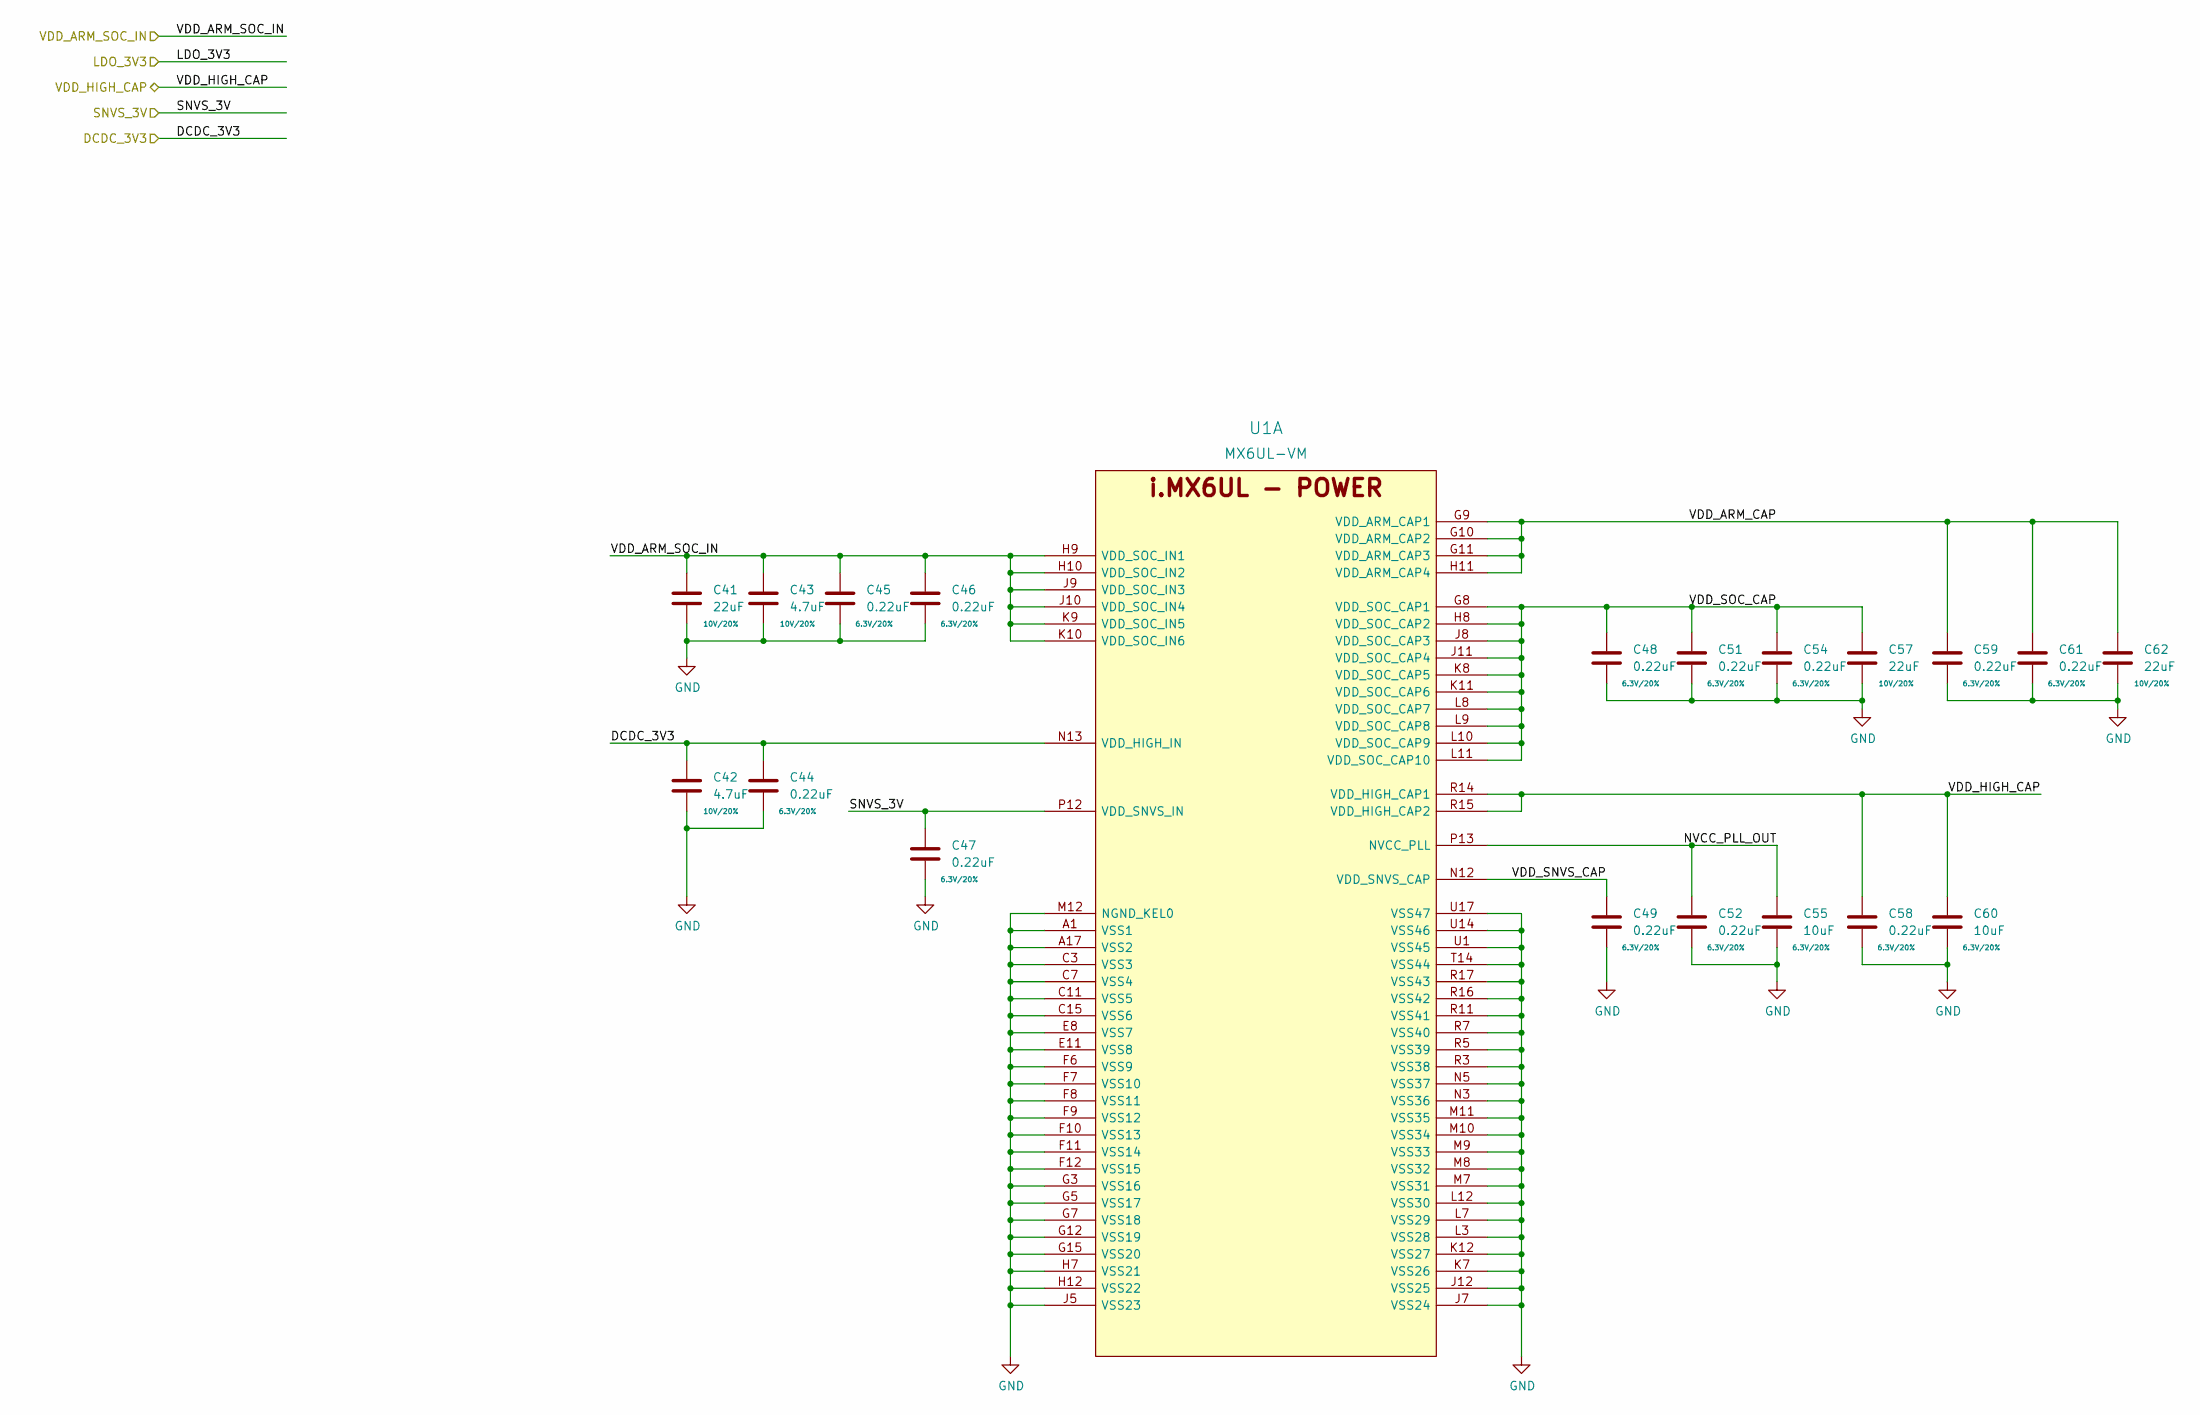
[picture p9: schematic imx6ull_power.kicad_sch]

Parts:
C41, C57, C62: 22uF; C_0603_1608Metric; Rating 10V/20%; MPN CL10A226MP8NUNE; DigiKey_PN 1276-1274-1-ND
C42, C43: 4.7uF; C_0402_1005Metric; Rating 10V/20%; MPN CL05A475MP5NRNC; DigiKey_PN 1276-1482-1-ND
C44, C45, C46, C47, C48, C49, C51, C52, C54, C58, C59, C61: 0.22uF; C_0201_0603Metric; Rating 6.3V/20%; MPN GRM033C80J224KE90D; DigiKey_PN 490-10392-1-ND
C55, C60: 10uF; C_0402_1005Metric; Rating 6.3V/20%; MPN GRM155R60J106ME05D; DigiKey_PN 490-GRM155R60J106ME05DCT-ND
U1: MX6UL-VM; SOT1534-2; MPN MCIMX6Y2DVM09AB; DigiKey_PN 568-14995-ND

Connections:
/IMX6ULL Power/NVCC_PLL_OUT: C52.1, C55.1, U1.P13 (NVCC_PLL)
/IMX6ULL Power/VDD_ARM_CAP: C59.1, C61.1, C62.1, U1.G9 (VDD_ARM_CAP1), U1.G10 (VDD_ARM_CAP2), U1.G11 (VDD_ARM_CAP3), U1.H11 (VDD_ARM_CAP4)
/IMX6ULL Power/VDD_SNVS_CAP: C49.1, U1.N12 (VDD_SNVS_CAP)
/IMX6ULL Power/VDD_SOC_CAP: C48.1, C51.1, C54.1, C57.1, U1.G8 (VDD_SOC_CAP1), U1.H8 (VDD_SOC_CAP2), U1.J8 (VDD_SOC_CAP3), U1.J11 (VDD_SOC_CAP4), U1.K8 (VDD_SOC_CAP5), U1.K11 (VDD_SOC_CAP6), U1.L8 (VDD_SOC_CAP7), U1.L9 (VDD_SOC_CAP8), U1.L10 (VDD_SOC_CAP9), U1.L11 (VDD_SOC_CAP10)
/SNVS_3V3: C47.1, U1.P12 (VDD_SNVS_IN); also elsewhere on the board
DCDC_3V3: C42.1, C44.1, U1.N13 (VDD_HIGH_IN); also elsewhere on the board
GND: C41.2, C42.2, C43.2, C44.2, C45.2, C46.2, C47.2, C48.2, C49.2, C51.2, C52.2, C54.2, C55.2, C57.2, C58.2, C59.2, C60.2, C61.2, C62.2, U1.A1 (VSS1), U1.A17 (VSS2), U1.C3 (VSS3), U1.C7 (VSS4), U1.C11 (VSS5), U1.C15 (VSS6), U1.E8 (VSS7), U1.E11 (VSS8), U1.F6 (VSS9), U1.F7 (VSS10), U1.F8 (VSS11), U1.F9 (VSS12), U1.F10 (VSS13), U1.F11 (VSS14), U1.F12 (VSS15), U1.G3 (VSS16), U1.G5 (VSS17), U1.G7 (VSS18), U1.G12 (VSS19), U1.G15 (VSS20), U1.H7 (VSS21), U1.H12 (VSS22), U1.J5 (VSS23), U1.J7 (VSS24), U1.J12 (VSS25), U1.K7 (VSS26), U1.K12 (VSS27), U1.L3 (VSS28), U1.L7 (VSS29), U1.L12 (VSS30), U1.M7 (VSS31), U1.M8 (VSS32), U1.M9 (VSS33), U1.M10 (VSS34), U1.M11 (VSS35), U1.M12 (NGND_KEL0), U1.N3 (VSS36), U1.N5 (VSS37), U1.R3 (VSS38), U1.R5 (VSS39), U1.R7 (VSS40), U1.R11 (VSS41), U1.R16 (VSS42), U1.R17 (VSS43), U1.T14 (VSS44), U1.U1 (VSS45), U1.U14 (VSS46), U1.U17 (VSS47); also elsewhere on the board
VDD_ARM_SOC_IN: C41.1, C43.1, C45.1, C46.1, U1.H9 (VDD_SOC_IN1), U1.H10 (VDD_SOC_IN2), U1.J9 (VDD_SOC_IN3), U1.J10 (VDD_SOC_IN4), U1.K9 (VDD_SOC_IN5), U1.K10 (VDD_SOC_IN6); also elsewhere on the board
VDD_HIGH_CAP: C58.1, C60.1, U1.R14 (VDD_HIGH_CAP1), U1.R15 (VDD_HIGH_CAP2); also elsewhere on the board

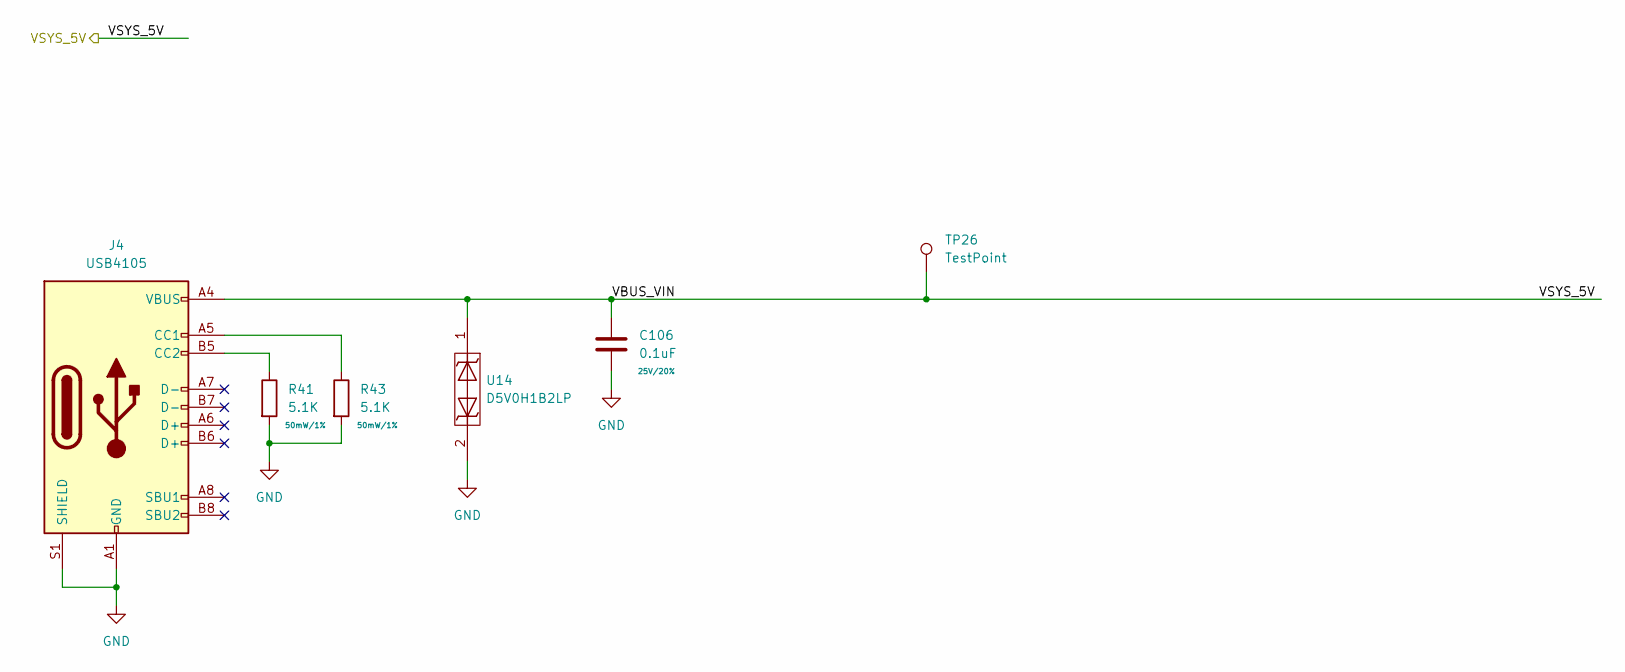
[picture p10: schematic vin.kicad_sch]

Parts:
C106: 0.1uF; C_0402_1005Metric; Rating 25V/20%; MPN GRM155R71E104KE14J; DigiKey_PN 490-14603-1-ND
J4: USB4105; USB_C_Receptacle_HRO_TYPE-C-31-M-12; MPN USB4105-GF-A; DigiKey_PN 2073-USB4105-GF-ACT-ND
R41, R43: 5.1K; R_0402_1005Metric; Rating 50mW/1%; MPN RC0402FR-075K1L; DigiKey_PN 311-5.10KLRCT-ND
TP26: TestPoint; TestPoint_Pad_D1.0mm
U14: D5V0H1B2LP; DFN100X60X45-2N; MPN D5V0H1B2LP-7B; DigiKey_PN D5V0H1B2LP-7BDICT-ND

Connections:
GND: C106.2, J4.A1 (GND), J4.A12 (GND), J4.B1 (GND), J4.B12 (GND), J4.S1 (SHIELD), R41.2, R43.2, U14.2; also elsewhere on the board
unnamed: J4.A5 (CC1), R43.1
unnamed: J4.B5 (CC2), R41.1
VSYS_5V: C106.1, J4.A4 (VBUS), J4.A9 (VBUS), J4.B4 (VBUS), J4.B9 (VBUS), TP26.1, U14.1; also elsewhere on the board

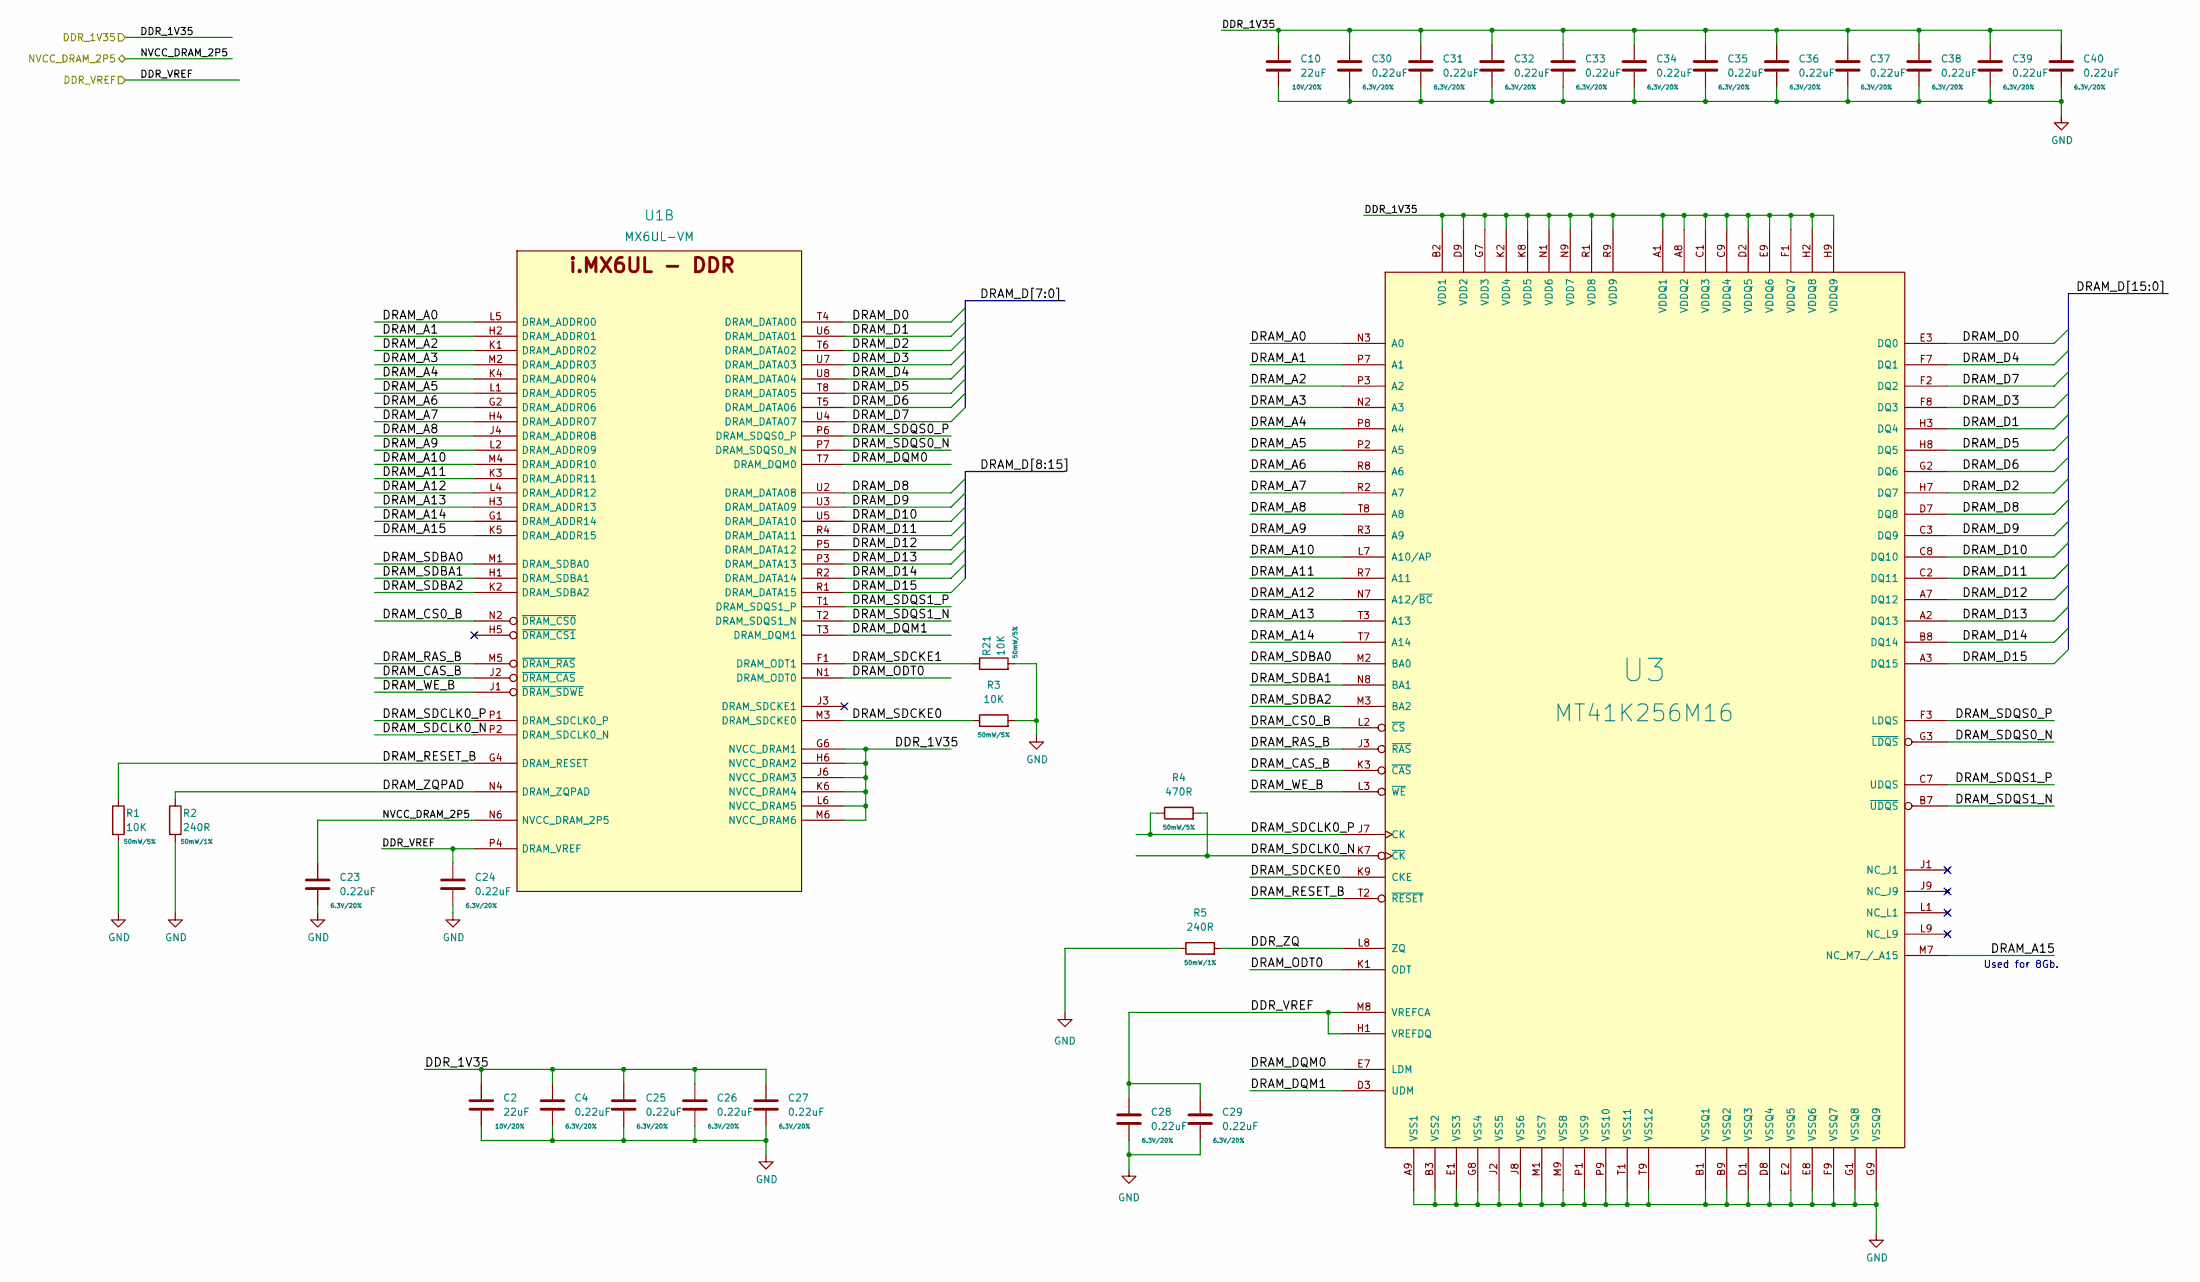
[picture p11: schematic ddr.kicad_sch]

Parts:
C2, C10: 22uF; C_0603_1608Metric; Rating 10V/20%; MPN CL10A226MP8NUNE; DigiKey_PN 1276-1274-1-ND
C4, C23, C24, C25, C26, C27, C28, C29, C30, C31, C32, C33, C34, C35, C36, C37, C38, C39, C40: 0.22uF; C_0201_0603Metric; Rating 6.3V/20%; MPN GRM033C80J224KE90D; DigiKey_PN 490-10392-1-ND
R1, R3, R21: 10K; R_0402_1005Metric; Rating 50mW/5%; MPN RC0402JR-0710KL; DigiKey_PN 311-10KJRCT-ND
R2, R5: 240R; R_0201_0603Metric; Rating 50mW/1%; MPN RC0201FR-07240RL; DigiKey_PN YAG2528CT-ND
R4: 470R; R_0201_0603Metric; Rating 50mW/5%; MPN RC0201JR-07470RL; DigiKey_PN 311-470NCT-ND
U1: MX6UL-VM; SOT1534-2; MPN MCIMX6Y2DVM09AB; DigiKey_PN 568-14995-ND
U3: MT41K256M16; MICRON-FBGA-96; MPN MT41K256M16TW-107:P; DigiKey_PN 557-1792-ND

Connections:
/DDR/DDR_ZQ: R5.2, U3.L8 (ZQ)
/DDR/DRAM_A0: U1.L5 (DRAM_ADDR00), U3.N3 (A0)
/DDR/DRAM_A1: U1.H2 (DRAM_ADDR01), U3.P7 (A1)
/DDR/DRAM_A2: U1.K1 (DRAM_ADDR02), U3.P3 (A2)
/DDR/DRAM_A3: U1.M2 (DRAM_ADDR03), U3.N2 (A3)
/DDR/DRAM_A4: U1.K4 (DRAM_ADDR04), U3.P8 (A4)
/DDR/DRAM_A5: U1.L1 (DRAM_ADDR05), U3.P2 (A5)
/DDR/DRAM_A6: U1.G2 (DRAM_ADDR06), U3.R8 (A6)
/DDR/DRAM_A7: U1.H4 (DRAM_ADDR07), U3.R2 (A7)
/DDR/DRAM_A8: U1.J4 (DRAM_ADDR08), U3.T8 (A8)
/DDR/DRAM_A9: U1.L2 (DRAM_ADDR09), U3.R3 (A9)
/DDR/DRAM_A10: U1.M4 (DRAM_ADDR10), U3.L7 (A10/AP)
/DDR/DRAM_A11: U1.K3 (DRAM_ADDR11), U3.R7 (A11)
/DDR/DRAM_A12: U1.L4 (DRAM_ADDR12), U3.N7 (A12/~BC)
/DDR/DRAM_A13: U1.H3 (DRAM_ADDR13), U3.T3 (A13)
/DDR/DRAM_A14: U1.G1 (DRAM_ADDR14), U3.T7 (A14)
/DDR/DRAM_A15: U1.K5 (DRAM_ADDR15), U3.M7 (NC_M7_/_A15)
/DDR/DRAM_CAS_B: U1.J2 (~DRAM_CAS), U3.K3 (~CAS)
/DDR/DRAM_CS0_B: U1.N2 (~DRAM_CS0), U3.L2 (~CS)
/DDR/DRAM_D0: U1.T4 (DRAM_DATA00), U3.E3 (DQ0)
/DDR/DRAM_D1: U1.U6 (DRAM_DATA01), U3.H3 (DQ4)
/DDR/DRAM_D2: U1.T6 (DRAM_DATA02), U3.H7 (DQ7)
/DDR/DRAM_D3: U1.U7 (DRAM_DATA03), U3.F8 (DQ3)
/DDR/DRAM_D4: U1.U8 (DRAM_DATA04), U3.F7 (DQ1)
/DDR/DRAM_D5: U1.T8 (DRAM_DATA05), U3.H8 (DQ5)
/DDR/DRAM_D6: U1.T5 (DRAM_DATA06), U3.G2 (DQ6)
/DDR/DRAM_D7: U1.U4 (DRAM_DATA07), U3.F2 (DQ2)
/DDR/DRAM_D8: U1.U2 (DRAM_DATA08), U3.D7 (DQ8)
/DDR/DRAM_D9: U1.U3 (DRAM_DATA09), U3.C3 (DQ9)
/DDR/DRAM_D10: U1.U5 (DRAM_DATA10), U3.C8 (DQ10)
/DDR/DRAM_D11: U1.R4 (DRAM_DATA11), U3.C2 (DQ11)
/DDR/DRAM_D12: U1.P5 (DRAM_DATA12), U3.A7 (DQ12)
/DDR/DRAM_D13: U1.P3 (DRAM_DATA13), U3.A2 (DQ13)
/DDR/DRAM_D14: U1.R2 (DRAM_DATA14), U3.B8 (DQ14)
/DDR/DRAM_D15: U1.R1 (DRAM_DATA15), U3.A3 (DQ15)
/DDR/DRAM_DQM0: U1.T7 (DRAM_DQM0), U3.E7 (LDM)
/DDR/DRAM_DQM1: U1.T3 (DRAM_DQM1), U3.D3 (UDM)
/DDR/DRAM_ODT0: U1.N1 (DRAM_ODT0), U3.K1 (ODT)
/DDR/DRAM_RAS_B: U1.M5 (~DRAM_RAS), U3.J3 (~RAS)
/DDR/DRAM_RESET_B: R1.1, U1.G4 (DRAM_RESET), U3.T2 (~RESET)
/DDR/DRAM_SDBA0: U1.M1 (DRAM_SDBA0), U3.M2 (BA0)
/DDR/DRAM_SDBA1: U1.H1 (DRAM_SDBA1), U3.N8 (BA1)
/DDR/DRAM_SDBA2: U1.K2 (DRAM_SDBA2), U3.M3 (BA2)
/DDR/DRAM_SDCKE0: R3.1, U1.M3 (DRAM_SDCKE0), U3.K9 (CKE)
/DDR/DRAM_SDCKE1: R21.1, U1.F1 (DRAM_ODT1)
/DDR/DRAM_SDCLK0_N: R4.2, U1.P2 (DRAM_SDCLK0_N), U3.K7 (~CK)
/DDR/DRAM_SDCLK0_P: R4.1, U1.P1 (DRAM_SDCLK0_P), U3.J7 (CK)
/DDR/DRAM_SDQS0_N: U1.P7 (DRAM_SDQS0_N), U3.G3 (~LDQS)
/DDR/DRAM_SDQS0_P: U1.P6 (DRAM_SDQS0_P), U3.F3 (LDQS)
/DDR/DRAM_SDQS1_N: U1.T2 (DRAM_SDQS1_N), U3.B7 (~UDQS)
/DDR/DRAM_SDQS1_P: U1.T1 (DRAM_SDQS1_P), U3.C7 (UDQS)
/DDR/DRAM_WE_B: U1.J1 (~DRAM_SDWE), U3.L3 (~WE)
/DDR/DRAM_ZQPAD: R2.1, U1.N4 (DRAM_ZQPAD)
DDR_1V35: C2.1, C4.1, C10.1, C25.1, C26.1, C27.1, C30.1, C31.1, C32.1, C33.1, C34.1, C35.1, C36.1, C37.1, C38.1, C39.1, C40.1, U1.G6 (NVCC_DRAM1), U1.H6 (NVCC_DRAM2), U1.J6 (NVCC_DRAM3), U1.K6 (NVCC_DRAM4), U1.L6 (NVCC_DRAM5), U1.M6 (NVCC_DRAM6), U3.A1 (VDDQ1), U3.A8 (VDDQ2), U3.B2 (VDD1), U3.C1 (VDDQ3), U3.C9 (VDDQ4), U3.D2 (VDDQ5), U3.D9 (VDD2), U3.E9 (VDDQ6), U3.F1 (VDDQ7), U3.G7 (VDD3), U3.H2 (VDDQ8), U3.H9 (VDDQ9), U3.K2 (VDD4), U3.K8 (VDD5), U3.N1 (VDD6), U3.N9 (VDD7), U3.R1 (VDD8), U3.R9 (VDD9); also elsewhere on the board
DDR_VREF: C24.1, C28.1, C29.1, U1.P4 (DRAM_VREF), U3.H1 (VREFDQ), U3.M8 (VREFCA); also elsewhere on the board
GND: C2.2, C4.2, C10.2, C23.2, C24.2, C25.2, C26.2, C27.2, C28.2, C29.2, C30.2, C31.2, C32.2, C33.2, C34.2, C35.2, C36.2, C37.2, C38.2, C39.2, C40.2, R1.2, R2.2, R3.2, R5.1, R21.2, U3.A9 (VSS1), U3.B1 (VSSQ1), U3.B3 (VSS2), U3.B9 (VSSQ2), U3.D1 (VSSQ3), U3.D8 (VSSQ4), U3.E1 (VSS3), U3.E2 (VSSQ5), U3.E8 (VSSQ6), U3.F9 (VSSQ7), U3.G1 (VSSQ8), U3.G8 (VSS4), U3.G9 (VSSQ9), U3.J2 (VSS5), U3.J8 (VSS6), U3.M1 (VSS7), U3.M9 (VSS8), U3.P1 (VSS9), U3.P9 (VSS10), U3.T1 (VSS11), U3.T9 (VSS12); also elsewhere on the board
VDD_HIGH_CAP: C23.1, U1.N6 (NVCC_DRAM_2P5); also elsewhere on the board

Notes on the sheet:
Used for 8Gb.

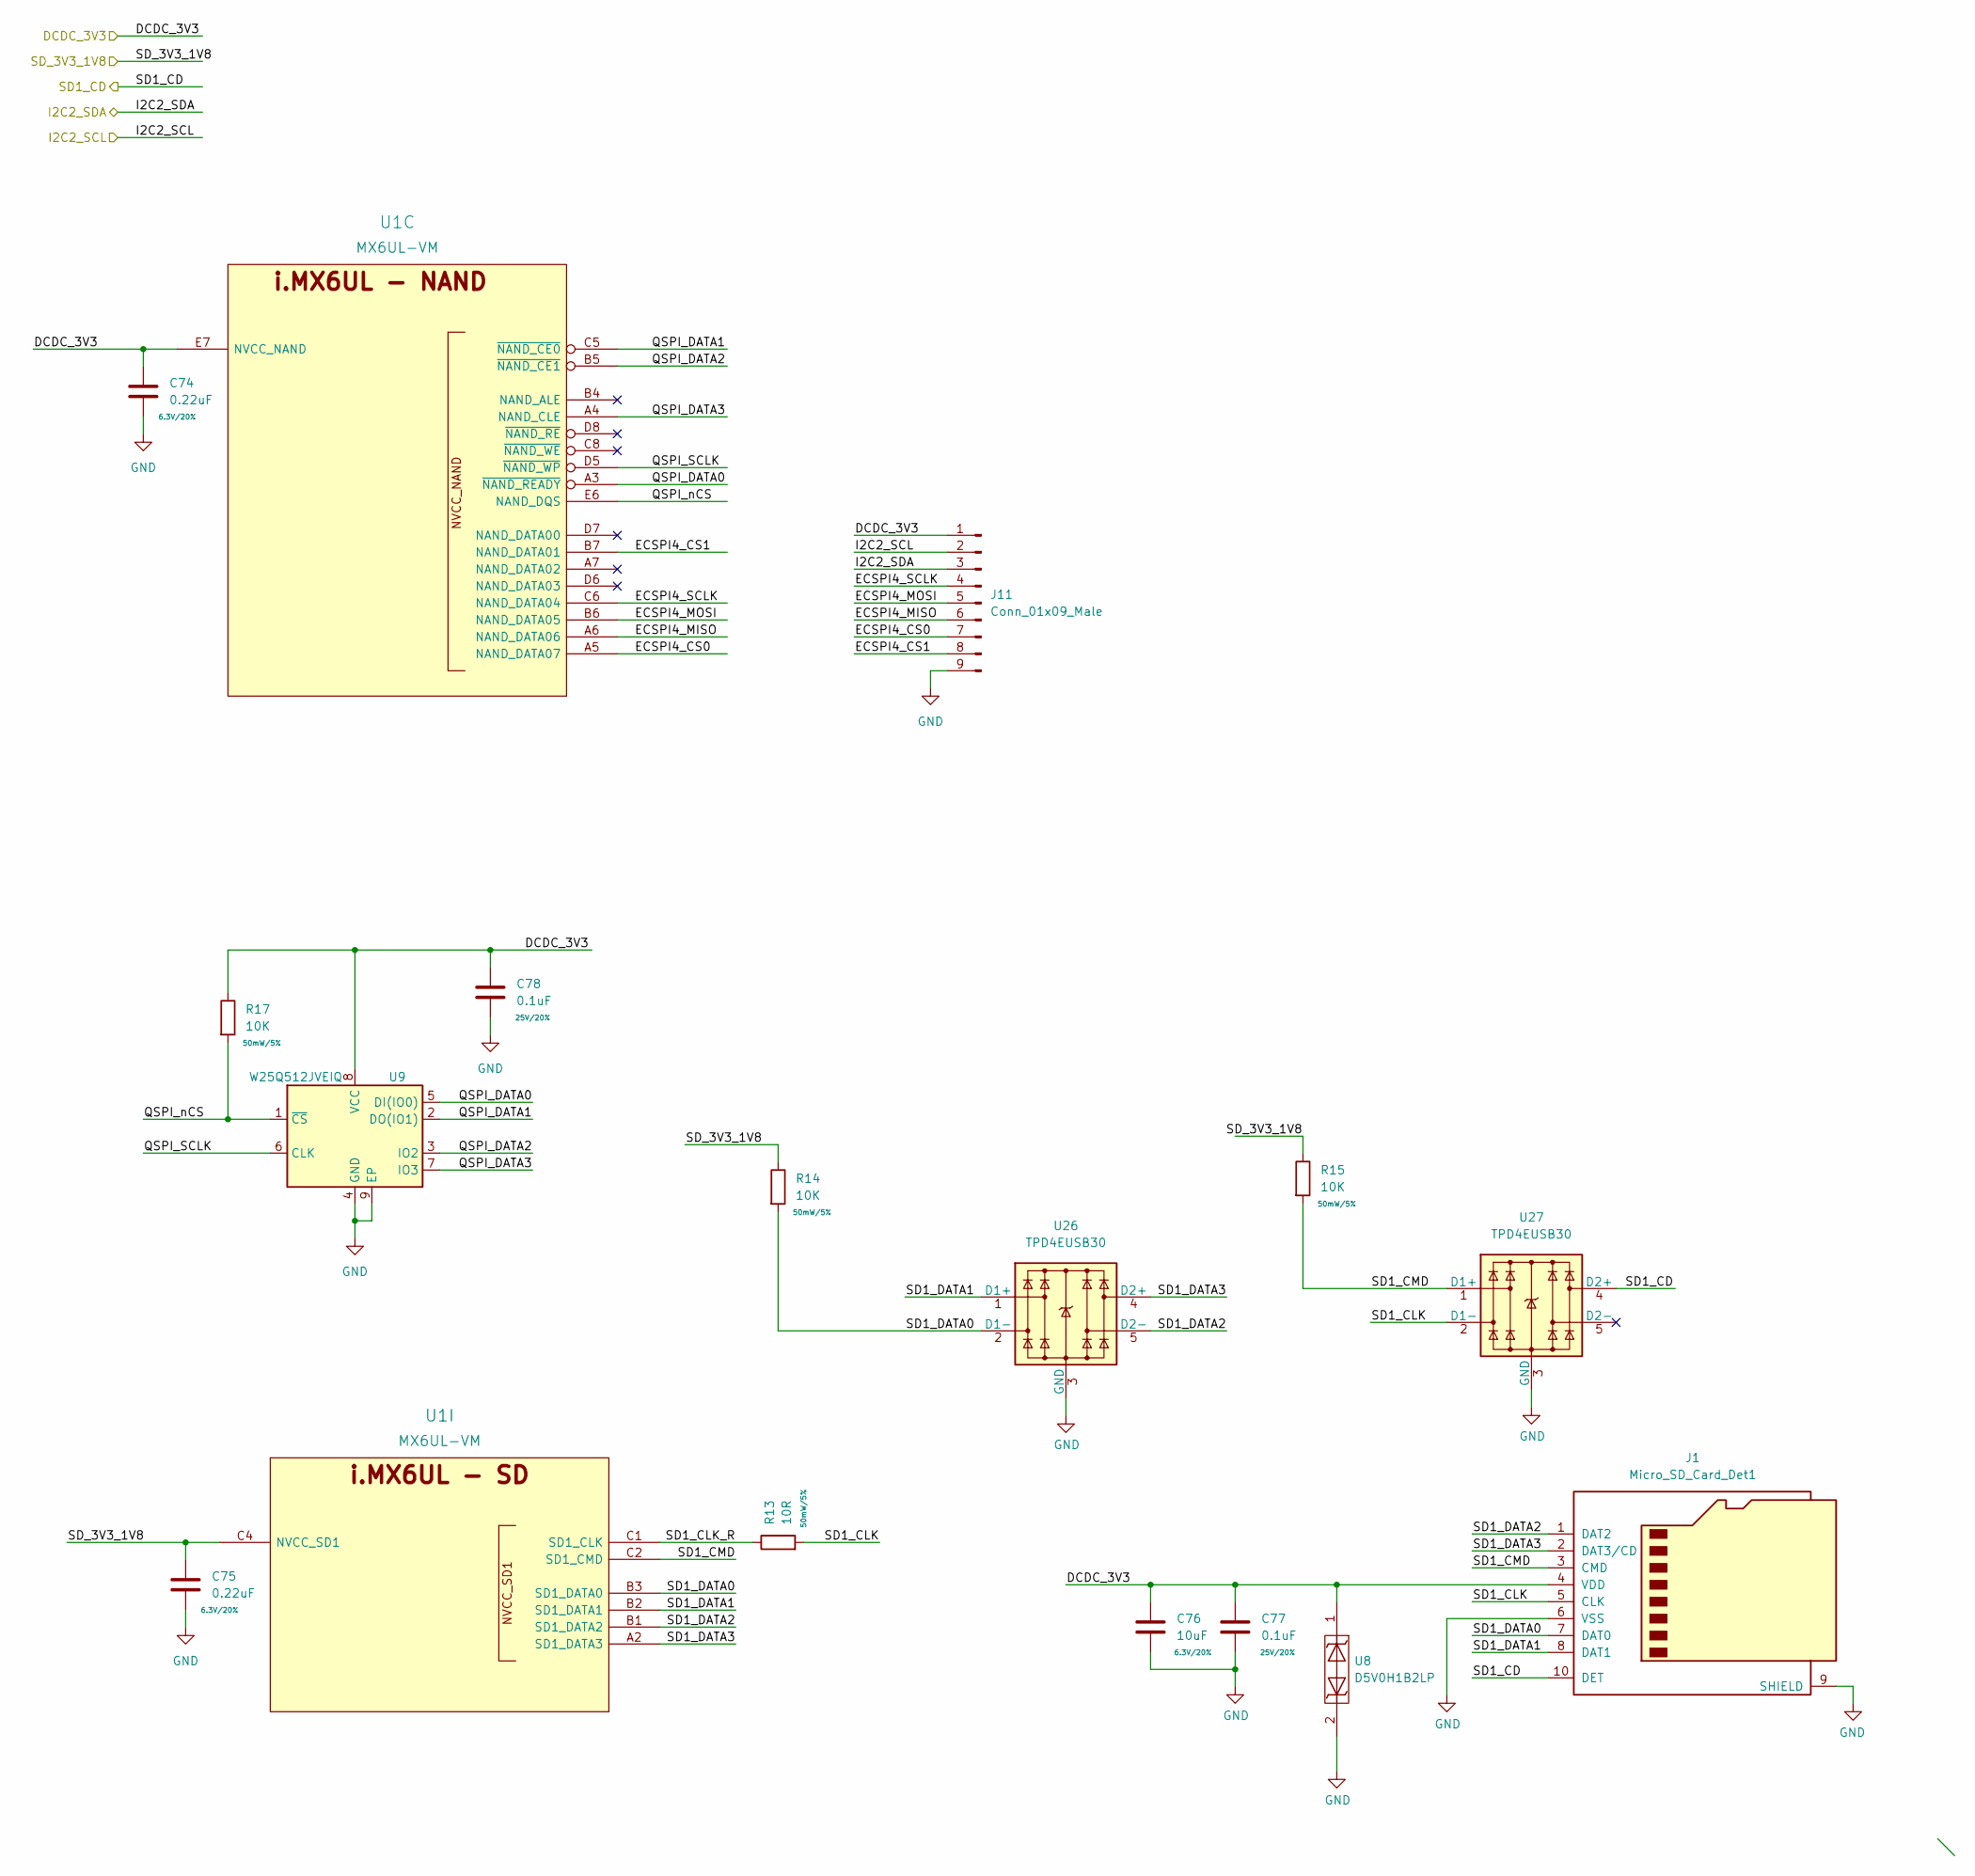
[picture p12: schematic storage.kicad_sch]

Parts:
C74, C75: 0.22uF; C_0201_0603Metric; Rating 6.3V/20%; MPN GRM033C80J224KE90D; DigiKey_PN 490-10392-1-ND
C76: 10uF; C_0402_1005Metric; Rating 6.3V/20%; MPN GRM155R60J106ME05D; DigiKey_PN 490-GRM155R60J106ME05DCT-ND
C77, C78: 0.1uF; C_0402_1005Metric; Rating 25V/20%; MPN GRM155R71E104KE14J; DigiKey_PN 490-14603-1-ND
J1: Micro_SD_Card_Det1; GCT_MEM2051-00-195-00-A_REVC; MPN MEM2051-00-195-00-A; DigiKey_PN 2073-MEM2051-00-195-00-ACT-ND
J11: Conn_01x09_Male; PinHeader_1x09_P1.27mm_Vertical; MPN GRPB091VWVN-RC; DigiKey_PN S9014E-09-ND
R13: 10R; R_0402_1005Metric; Rating 50mW/5%; MPN RC0402JR-0710RL; DigiKey_PN 311-10JRCT-ND
R14, R15, R17: 10K; R_0402_1005Metric; Rating 50mW/5%; MPN RC0402JR-0710KL; DigiKey_PN 311-10KJRCT-ND
U1: MX6UL-VM; SOT1534-2; MPN MCIMX6Y2DVM09AB; DigiKey_PN 568-14995-ND
U8: D5V0H1B2LP; DFN100X60X45-2N; MPN D5V0H1B2LP-7B; DigiKey_PN D5V0H1B2LP-7BDICT-ND
U9: W25Q512JVEIQ; WSON-8-1EP_6x5mm_P1.27mm_EP3.4x4.3mm; MPN W25Q32JVZPIQ; DigiKey_PN W25Q32JVZPIQ-ND
U26, U27: TPD4EUSB30; USON-10_2.5x1.0mm_P0.5mm; MPN TPD4EUSB30DQAR; DigiKey_PN 296-28063-1-ND

Connections:
/Storage/ECSPI4_CS0: J11.7, U1.A5 (NAND_DATA07)
/Storage/ECSPI4_CS1: J11.8, U1.B7 (NAND_DATA01)
/Storage/ECSPI4_MISO: J11.6, U1.A6 (NAND_DATA06)
/Storage/ECSPI4_MOSI: J11.5, U1.B6 (NAND_DATA05)
/Storage/ECSPI4_SCLK: J11.4, U1.C6 (NAND_DATA04)
/Storage/QSPI_DATA0: U1.A3 (~NAND_READY), U9.5 (DI(IO0))
/Storage/QSPI_DATA1: U1.C5 (~NAND_CE0), U9.2 (DO(IO1))
/Storage/QSPI_DATA2: U1.B5 (~NAND_CE1), U9.3 (IO2)
/Storage/QSPI_DATA3: U1.A4 (NAND_CLE), U9.7 (IO3)
/Storage/QSPI_SCLK: U1.D5 (~NAND_WP), U9.6 (CLK)
/Storage/QSPI_nCS: R17.2, U1.E6 (NAND_DQS), U9.1 (~CS)
/Storage/SD1_CLK: J1.5 (CLK), R13.2, U27.2 (D1-), U27.9
/Storage/SD1_CLK_R: R13.1, U1.C1 (SD1_CLK)
/Storage/SD1_CMD: J1.3 (CMD), R15.2, U1.C2 (SD1_CMD), U27.1 (D1+), U27.10
/Storage/SD1_DATA0: J1.7 (DAT0), R14.2, U1.B3 (SD1_DATA0), U26.2 (D1-), U26.9
/Storage/SD1_DATA1: J1.8 (DAT1), U1.B2 (SD1_DATA1), U26.1 (D1+), U26.10
/Storage/SD1_DATA2: J1.1 (DAT2), U1.B1 (SD1_DATA2), U26.5 (D2-), U26.6
/Storage/SD1_DATA3: J1.2 (DAT3/CD), U1.A2 (SD1_DATA3), U26.4 (D2+), U26.7
DCDC_3V3: C74.1, C76.1, C77.1, C78.1, J1.4 (VDD), J11.1, R17.1, U1.E7 (NVCC_NAND), U8.1, U9.8 (VCC); also elsewhere on the board
GND: C74.2, C75.2, C76.2, C77.2, C78.2, J1.6 (VSS), J1.9 (SHIELD), J11.9, U8.2, U9.4 (GND), U9.9 (EP), U26.3 (GND), U26.8 (GND), U27.3 (GND), U27.8 (GND); also elsewhere on the board
I2C2_SCL: J11.2; also elsewhere on the board
I2C2_SDA: J11.3; also elsewhere on the board
SD1_CD: J1.10 (DET), U27.4 (D2+), U27.7; also elsewhere on the board
SD_3V3_1V8: C75.1, R14.1, R15.1, U1.C4 (NVCC_SD1); also elsewhere on the board
