quentin-z80/qsbc-zero/qsbc-zero.kicad_pcb

## KiCad design qsbc-zero.kicad_pcb (continued)

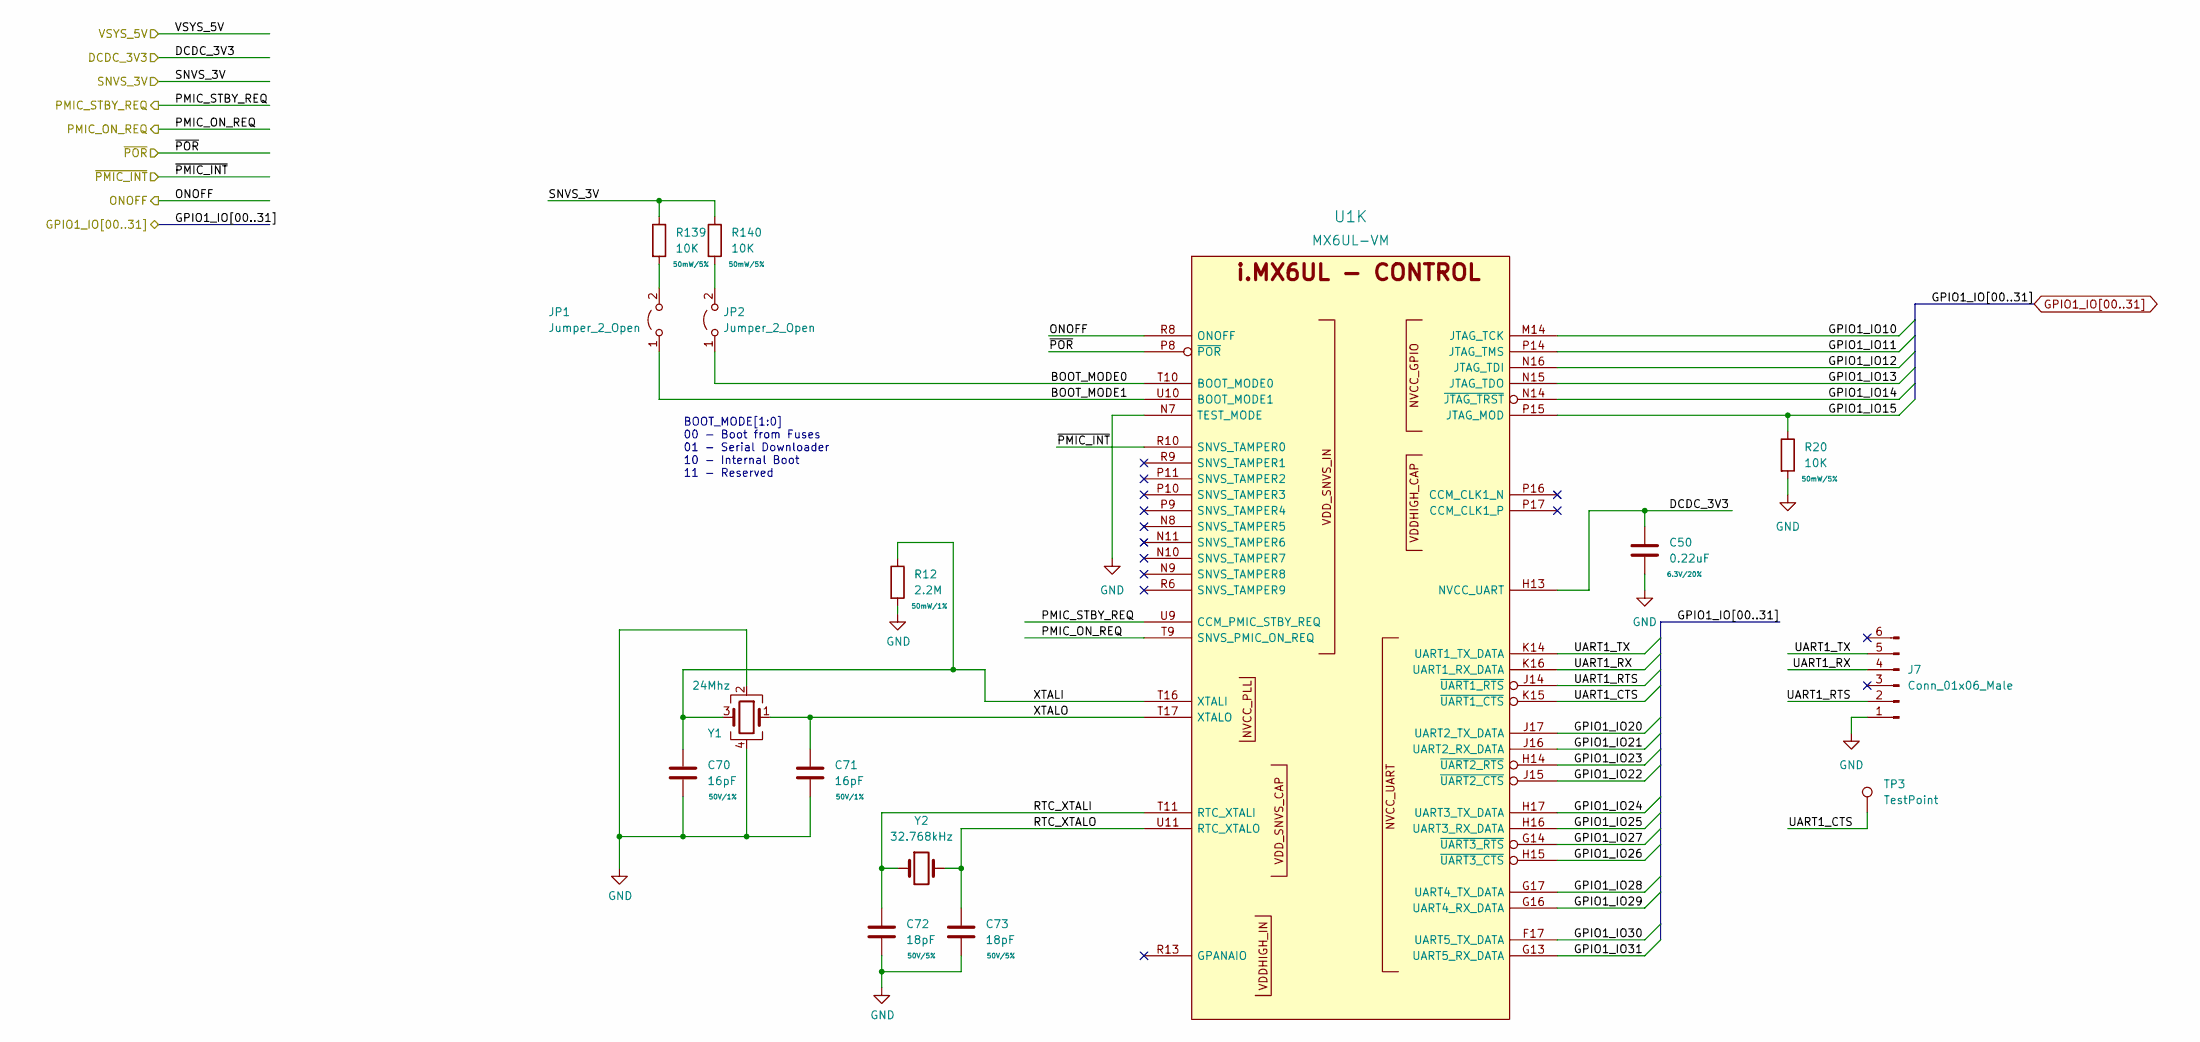
[picture p13: schematic control.kicad_sch]

Parts:
C50: 0.22uF; C_0201_0603Metric; Rating 6.3V/20%; MPN GRM033C80J224KE90D; DigiKey_PN 490-10392-1-ND
C70, C71: 16pF; C_0402_1005Metric; Rating 50V/1%; MPN GCM1555C1H160JA16D; DigiKey_PN 490-GCM1555C1H160JA16DCT-ND
C72, C73: 18pF; C_0402_1005Metric; Rating 50V/5%; MPN CC0402JRNPO9BN180; DigiKey_PN 311-1415-1-ND
J7: Conn_01x06_Male; Harwin_M20-89006xx_1x06_P2.54mm_Horizontal; MPN M20-8900605; DigiKey_PN 952-3267-ND
JP1, JP2: Jumper_2_Open; SolderJumper-2_P1.3mm_Open_RoundedPad1.0x1.5mm
R12: 2.2M; R_0402_1005Metric; Rating 50mW/1%; MPN RC0402FR-132M2L; DigiKey_PN 13-RC0402FR-132M2LCT-ND
R20, R139, R140: 10K; R_0402_1005Metric; Rating 50mW/5%; MPN RC0402JR-0710KL; DigiKey_PN 311-10KJRCT-ND
TP3: TestPoint; TestPoint_Pad_D1.0mm
U1: MX6UL-VM; SOT1534-2; MPN MCIMX6Y2DVM09AB; DigiKey_PN 568-14995-ND
Y1: 24Mhz; Crystal_SMD_3225-4Pin_3.2x2.5mm; MPN ECS-240-9-33B-CWN-TR; DigiKey_PN XC2477CT-ND
Y2: 32.768kHz; Crystal_SMD_3215-2Pin_3.2x1.5mm; MPN CM315D32768EZFT; DigiKey_PN 300-8816-1-ND

Connections:
/Control/BOOT_MODE0: JP2.1 (A), U1.T10 (BOOT_MODE0)
/Control/BOOT_MODE1: JP1.1 (A), U1.U10 (BOOT_MODE1)
/Control/RTC_XTALI: C72.1, U1.T11 (RTC_XTALI), Y2.1
/Control/RTC_XTALO: C73.1, U1.U11 (RTC_XTALO), Y2.2
/Control/UART1_CTS: TP3.1, U1.K15 (~UART1_CTS)
/Control/UART1_RTS: J7.2, U1.J14 (~UART1_RTS)
/Control/UART1_RX: J7.4, U1.K16 (UART1_RX_DATA)
/Control/UART1_TX: J7.5, U1.K14 (UART1_TX_DATA)
/Control/XTALI: C70.1, R12.1, U1.T16 (XTALI), Y1.3
/Control/XTALO: C71.1, U1.T17 (XTALO), Y1.1
/SNVS_3V3: R139.1, R140.1; also elsewhere on the board
DCDC_3V3: C50.1, U1.H13 (NVCC_UART); also elsewhere on the board
GND: C50.2, C70.2, C71.2, C72.2, C73.2, J7.1, R12.2, R20.2, U1.N7 (TEST_MODE), Y1.2, Y1.4; also elsewhere on the board
GPIO1_IO10: U1.M14 (JTAG_TCK); also elsewhere on the board
GPIO1_IO11: U1.P14 (JTAG_TMS); also elsewhere on the board
GPIO1_IO12: U1.N16 (JTAG_TDI); also elsewhere on the board
GPIO1_IO13: U1.N15 (JTAG_TDO); also elsewhere on the board
GPIO1_IO14: U1.N14 (~JTAG_TRST); also elsewhere on the board
GPIO1_IO15: R20.1, U1.P15 (JTAG_MOD); also elsewhere on the board
GPIO1_IO20: U1.J17 (UART2_TX_DATA); also elsewhere on the board
GPIO1_IO21: U1.J16 (UART2_RX_DATA); also elsewhere on the board
GPIO1_IO22: U1.J15 (~UART2_CTS); also elsewhere on the board
GPIO1_IO23: U1.H14 (~UART2_RTS); also elsewhere on the board
GPIO1_IO24: U1.H17 (UART3_TX_DATA); also elsewhere on the board
GPIO1_IO25: U1.H16 (UART3_RX_DATA); also elsewhere on the board
GPIO1_IO26: U1.H15 (~UART3_CTS); also elsewhere on the board
GPIO1_IO27: U1.G14 (~UART3_RTS); also elsewhere on the board
GPIO1_IO28: U1.G17 (UART4_TX_DATA); also elsewhere on the board
GPIO1_IO29: U1.G16 (UART4_RX_DATA); also elsewhere on the board
GPIO1_IO30: U1.F17 (UART5_TX_DATA); also elsewhere on the board
GPIO1_IO31: U1.G13 (UART5_RX_DATA); also elsewhere on the board
IMX6_ONOFF: U1.R8 (ONOFF); also elsewhere on the board
unnamed: JP1.2 (B), R139.2
unnamed: JP2.2 (B), R140.2
PMIC_ON_REQ: U1.T9 (SNVS_PMIC_ON_REQ); also elsewhere on the board
PMIC_STBY_REQ: U1.U9 (CCM_PMIC_STBY_REQ); also elsewhere on the board
~PMIC_INT: U1.R10 (SNVS_TAMPER0); also elsewhere on the board
~POR: U1.P8 (~POR); also elsewhere on the board

Notes on the sheet:
BOOT_MODE[1:0] 00 - Boot from Fuses 01 - Serial Downloader 10 - Internal Boot 11 - Reserved

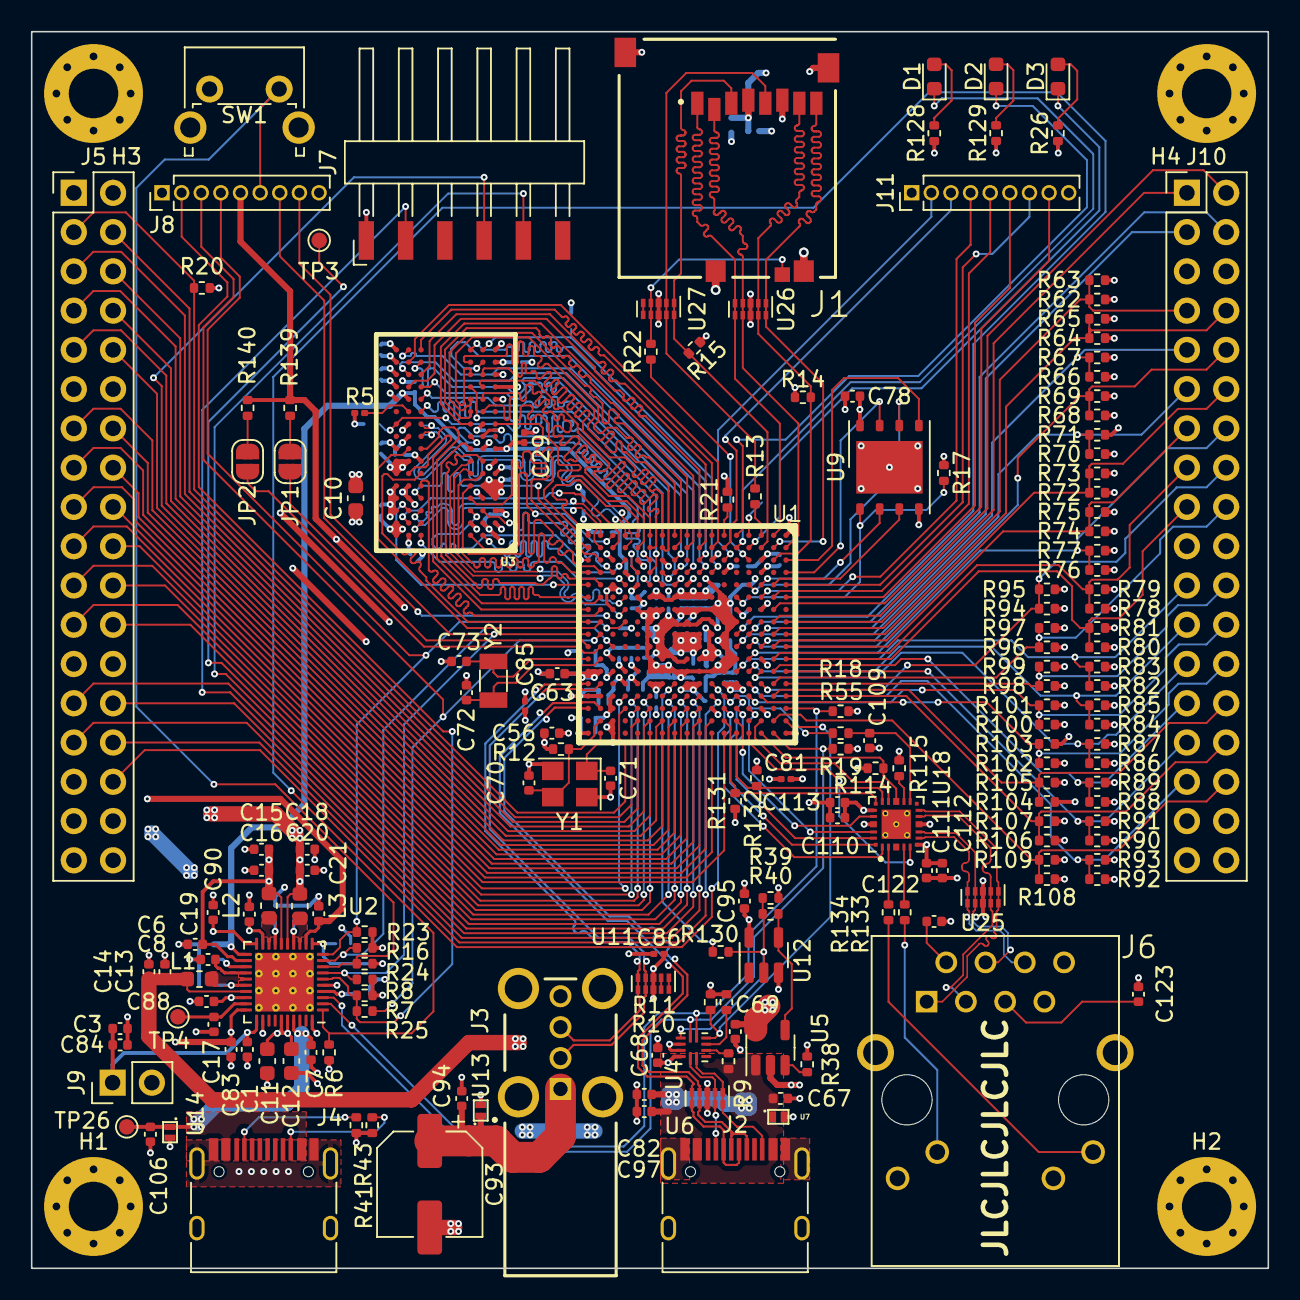
[picture p14: board qsbc-zero.kicad_pcb from above]

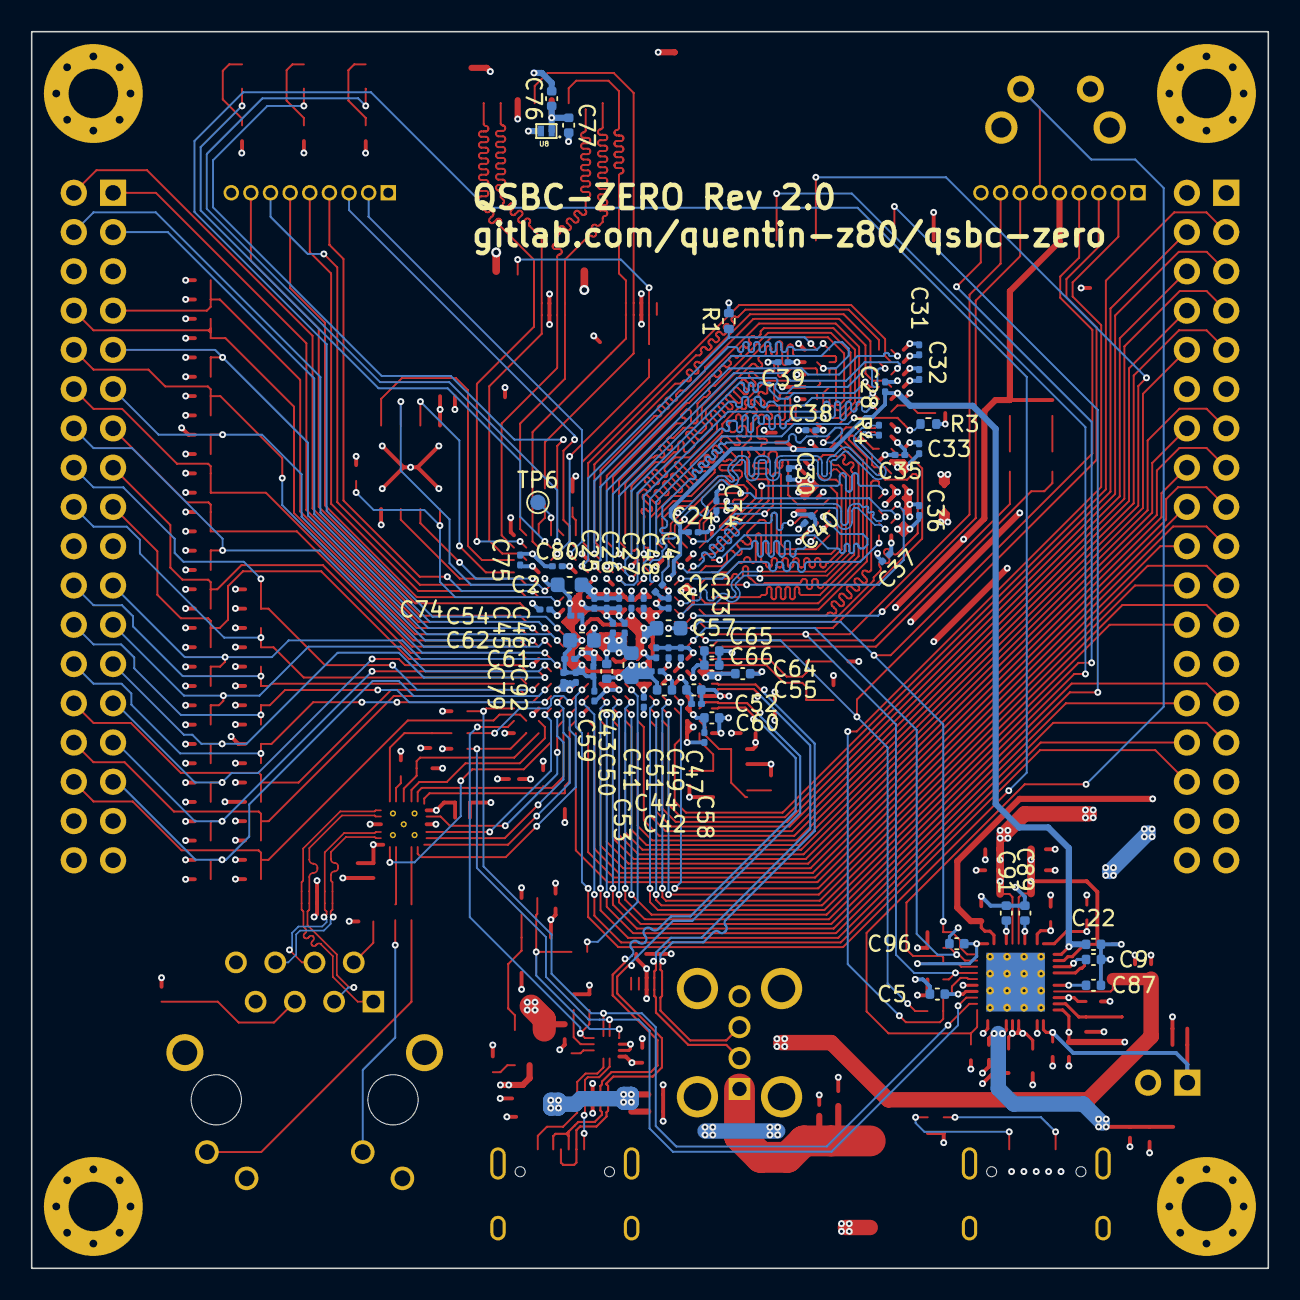
[picture p15: board qsbc-zero.kicad_pcb from below]

Board: 4 copper layers, 80.0 x 80.0 mm, 243 parts (63 on the bottom side), 219 nets.
