quentin-z80/qsbc-zero/(commit log)

2021-12-24 first ddr routing attempt
    [boot.kicad_sch, control.kicad_sch, ddr.kicad_sch, imx6ull-sbc.kicad_pcb, imx6ull-sbc.kicad_sch, imx6ull_power.kicad_sch, peripherals.kicad_sch, pmic.kicad_sch]
2021-12-30 more ddr routing, add more connectors
    [boot.kicad_sch, control.kicad_sch, ddr.kicad_sch, ethernet.kicad_sch, imx6ull-sbc.kicad_pcb, imx6ull-sbc.kicad_sch, imx6ull_power.kicad_sch, pmic.kicad_sch]
2022-01-01 start moving to hierarchal labels, add emmc
    [boot.kicad_sch, control.kicad_sch, ddr.kicad_sch, imx6ull-sbc.kicad_pcb, imx6ull-sbc.kicad_sch, imx6ull_power.kicad_sch, peripherals.kicad_sch, pmic.kicad_sch]
2022-01-06 move to hierarchal labels, work on power tree, add basic pcb layout
    [control.kicad_sch, ddr.kicad_sch, ethernet.kicad_sch, imx6ull-sbc.kicad_pcb, imx6ull-sbc.kicad_sch, imx6ull_power.kicad_sch, peripherals.kicad_sch, pmic.kicad_sch]
2022-01-09 most of sch done, inital component pcb placement
    [control.kicad_sch, ethernet.kicad_sch, imx6ull-sbc.kicad_pcb, imx6ull-sbc.kicad_sch, peripherals.kicad_sch, power.kicad_sch, storage.kicad_sch, usb.kicad_sch]
2022-02-06 lots of routing, ddr length matching done
    [boot.kicad_sch, control.kicad_sch, ddr.kicad_sch, ethernet.kicad_sch, imx6ull-sbc.kicad_pcb, imx6ull_power.kicad_sch, peripherals.kicad_sch, power.kicad_sch]
2022-02-15 more pcb work, bom work
    [control.kicad_sch, ddr.kicad_sch, ethernet.kicad_sch, imx6ull_power.kicad_sch, peripherals.kicad_sch, power.kicad_sch, qsbc-zero.kicad_pcb, qsbc-zero.kicad_sch]
2022-02-25 add basic readme, rev 1 of pcb
    [control.kicad_sch, ddr.kicad_sch, imx6ull_power.kicad_sch, peripherals.kicad_sch, power.kicad_sch, qsbc-zero.kicad_pcb, qsbc-zero.kicad_sch, storage.kicad_sch]
2022-03-01 remove uneeded symbols, footprints, and 3d models
2022-03-15 misc fixes, add pics of board
    [peripherals.kicad_sch, qsbc-zero.kicad_pcb, storage.kicad_sch]
2022-04-03 misc rev2 fixes
    [ddr.kicad_sch, peripherals.kicad_sch, power.kicad_sch, qsbc-zero.kicad_pcb, qsbc-zero.kicad_sch, storage.kicad_sch, usb.kicad_sch]
2022-04-05 fix cap PN
    [power.kicad_sch]
2022-04-05 tusb320: fix swaped SDA/SCL
    [qsbc-zero.kicad_pcb, usb.kicad_sch]
2022-04-05 tusb320: use drp mode
    [qsbc-zero.kicad_pcb, usb.kicad_sch]
2022-08-09 cleanup schematic junk
    [control.kicad_sch, ddr.kicad_sch, ethernet.kicad_sch, imx6ull_power.kicad_sch, peripherals.kicad_sch, qsbc-zero.kicad_pcb, storage.kicad_sch, usb.kicad_sch]
2022-08-09 README.md: add pcb manufacturing info
2023-01-16 add photo of blank board
